nySe08/radar-chip-24ghz/divider/div_sensitivity.png

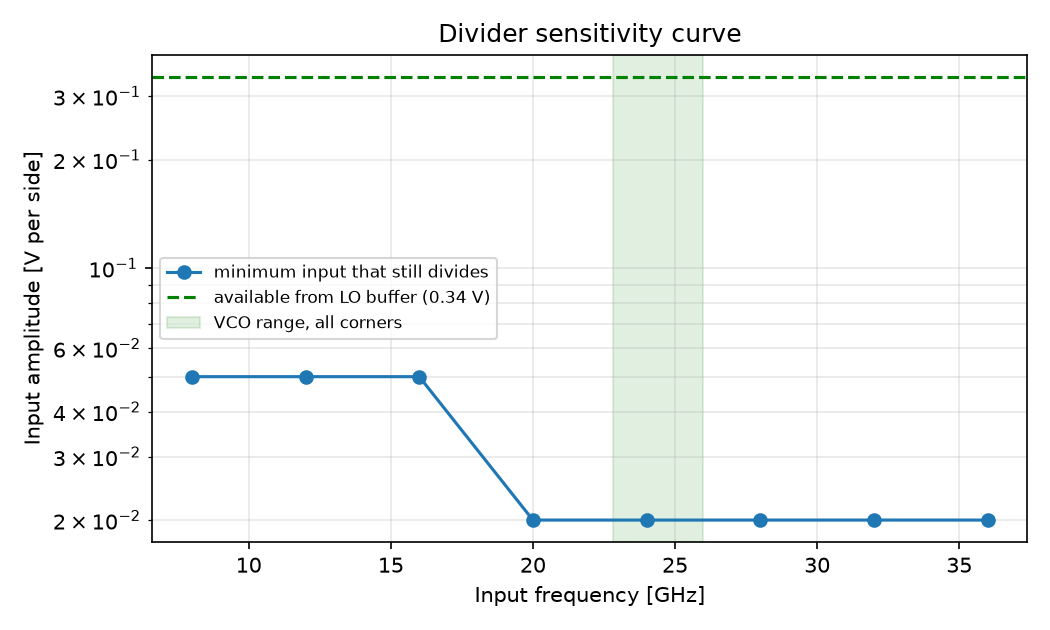
divider/div_sensitivity.png
