nySe08/radar-chip-24ghz/docs/chip_floorplan.png

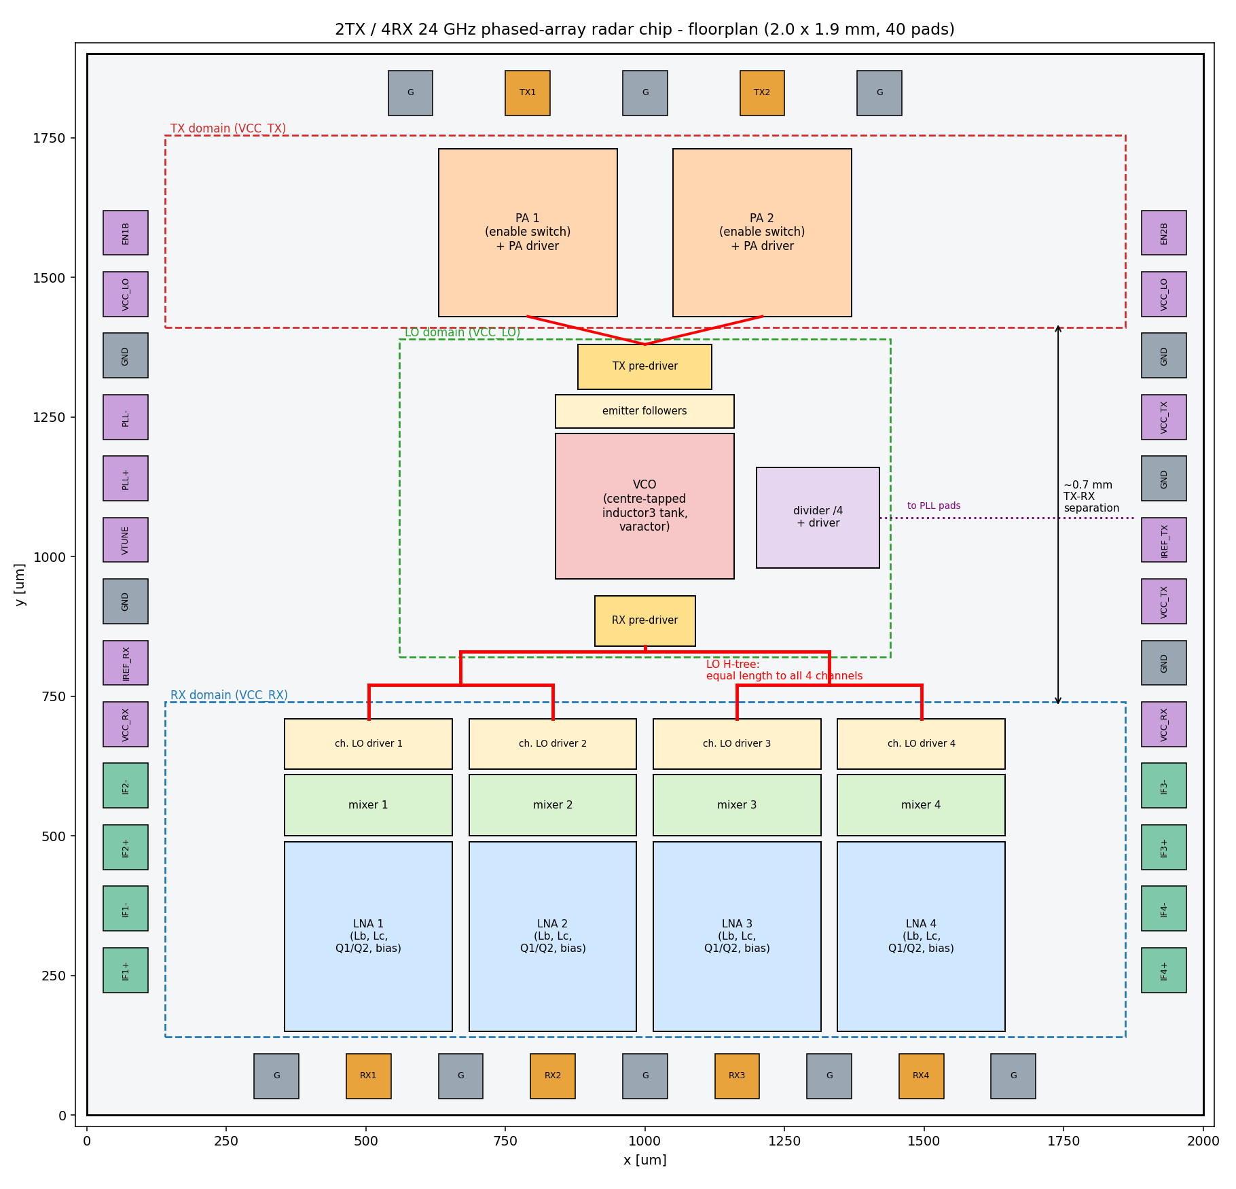
docs/chip_floorplan.png
