nySe08/radar-chip-24ghz/docs/cml_latch.png

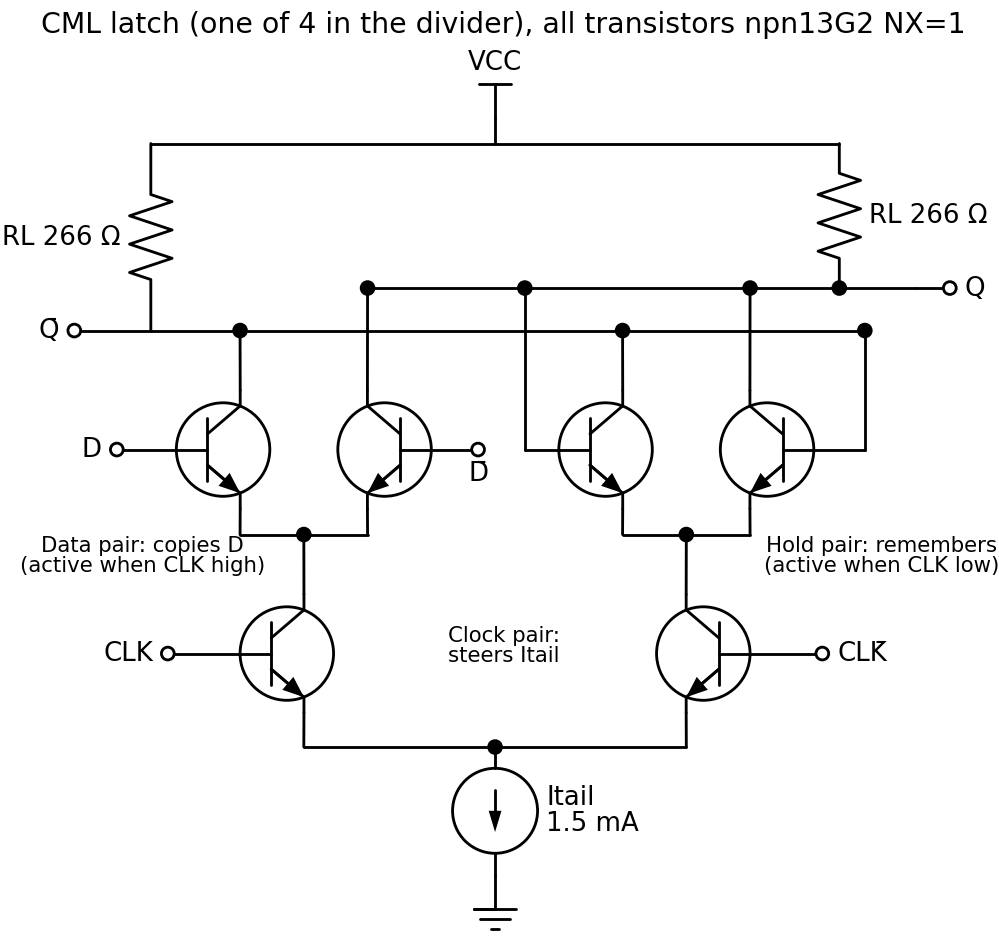
docs/cml_latch.png
