nySe08/radar-chip-24ghz/docs/div4_block.png

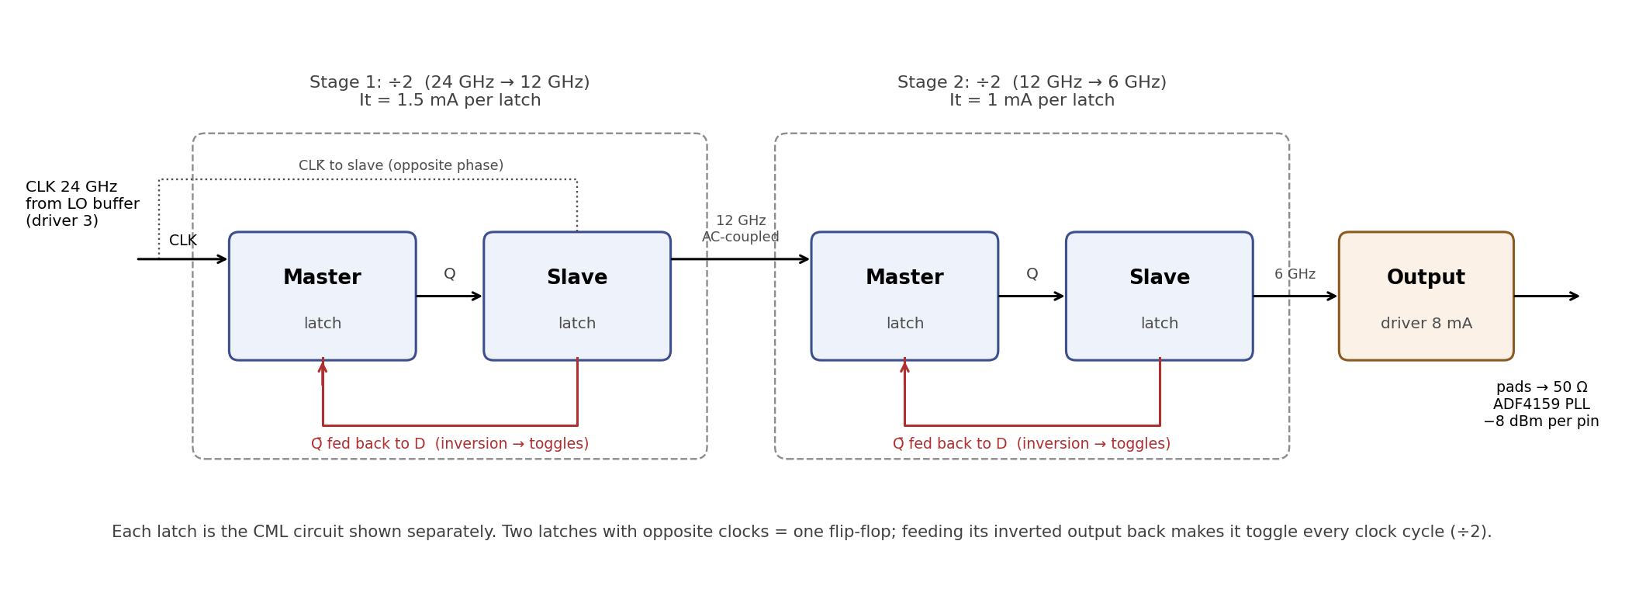
docs/div4_block.png
