nySe08/radar-chip-24ghz/docs/lna_schematic.png

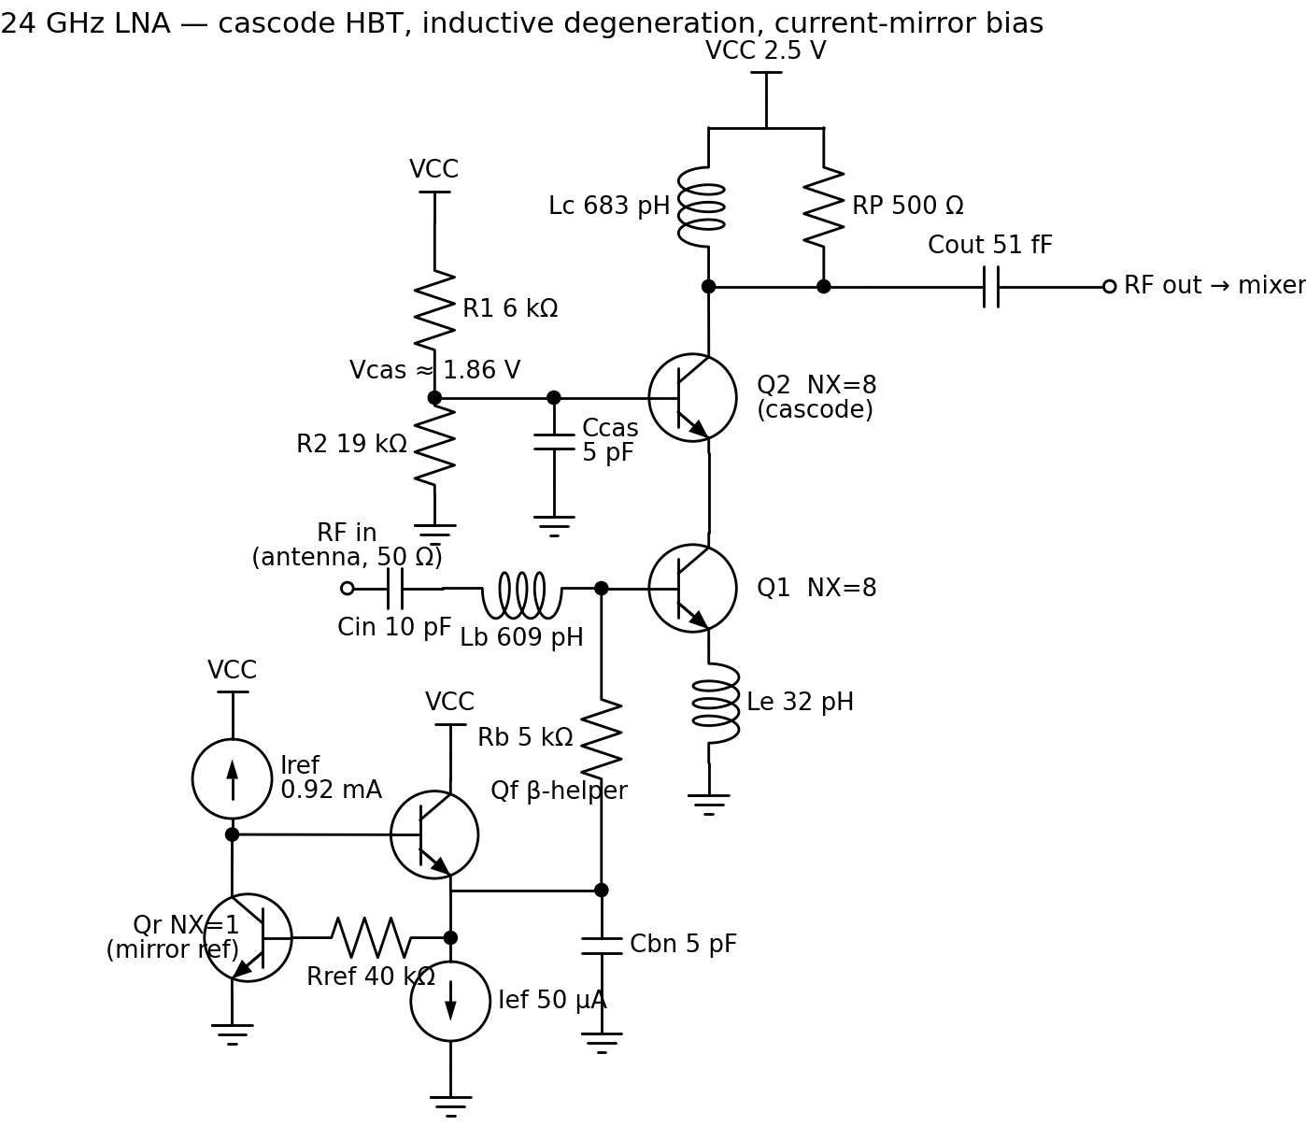
docs/lna_schematic.png
