nySe08/radar-chip-24ghz/docs/mixer_schematic.png

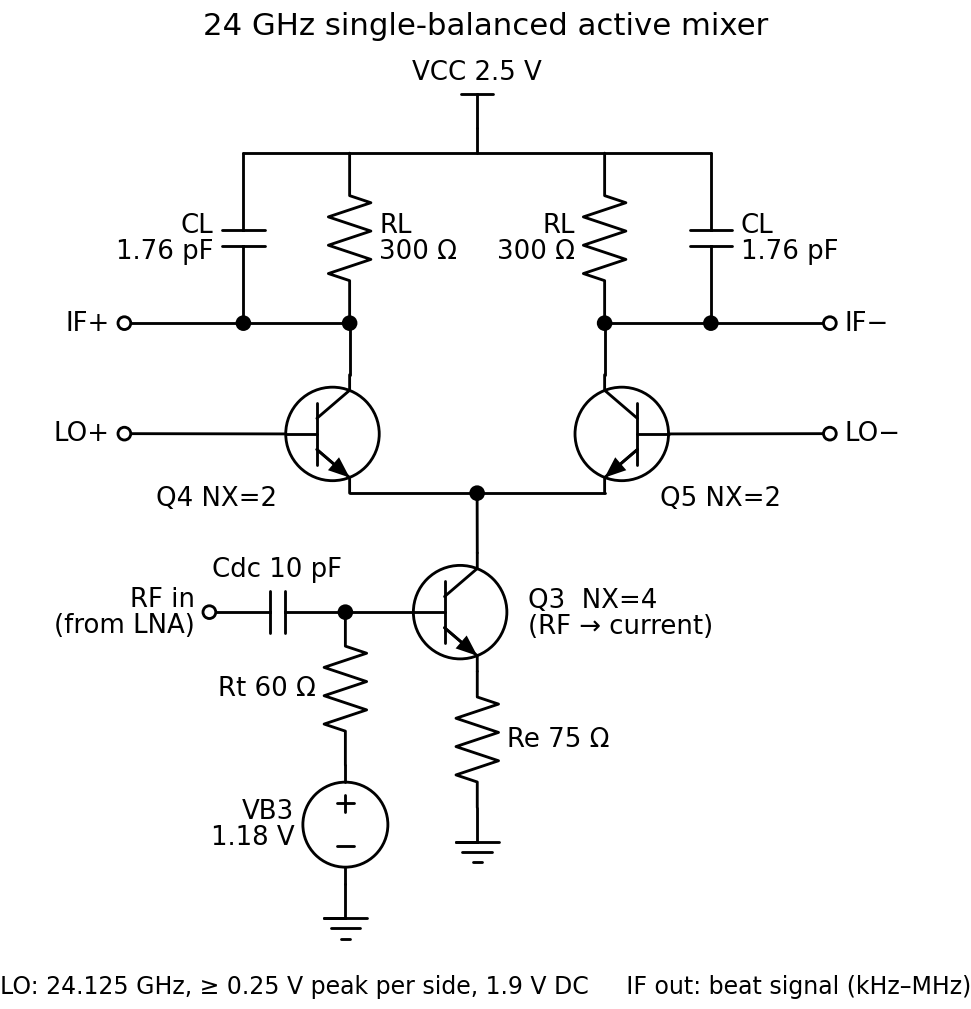
docs/mixer_schematic.png
