nySe08/radar-chip-24ghz/docs/pa_schematic.png

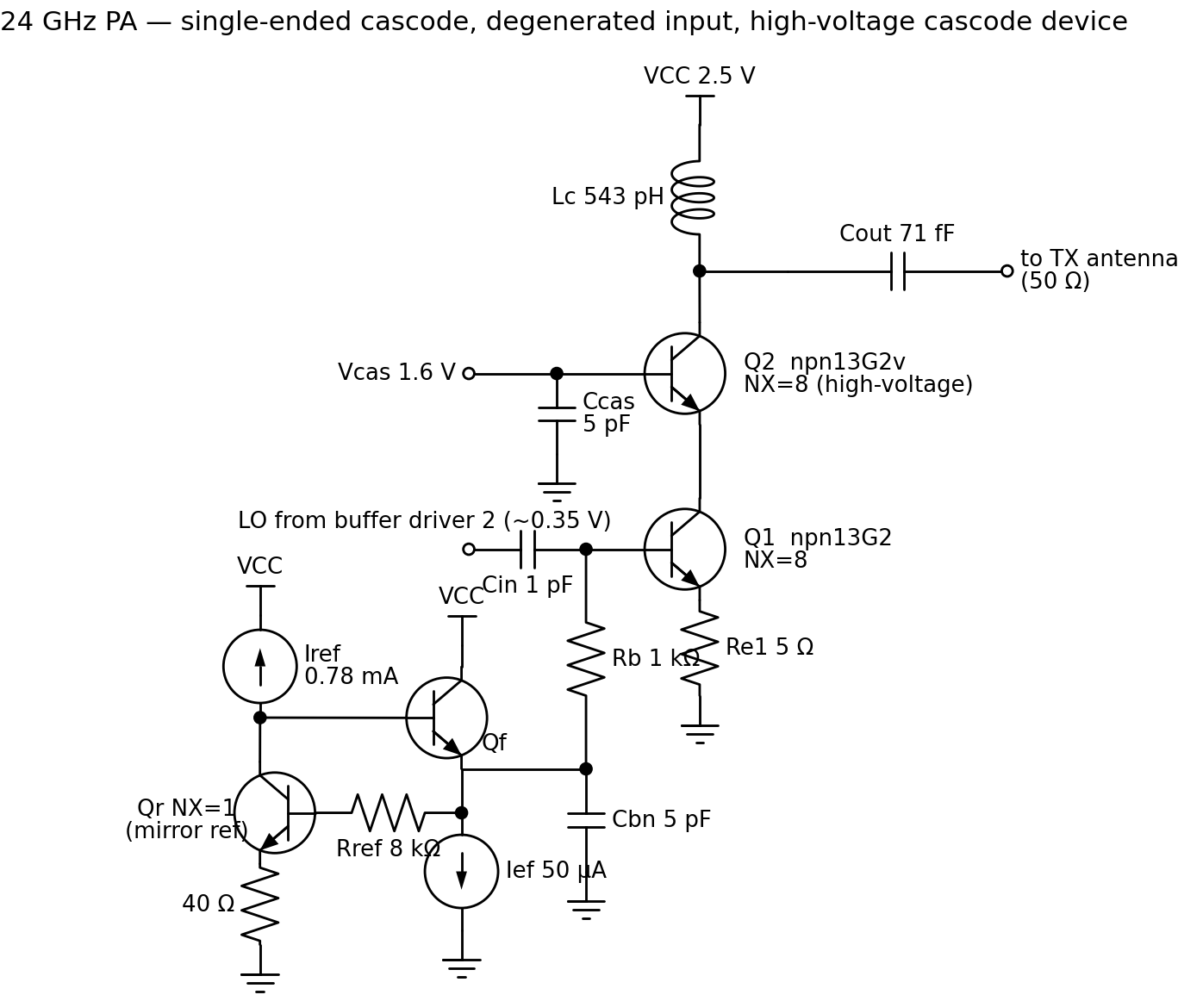
docs/pa_schematic.png
