nySe08/radar-chip-24ghz/floorplan/floorplan_full_chip.png

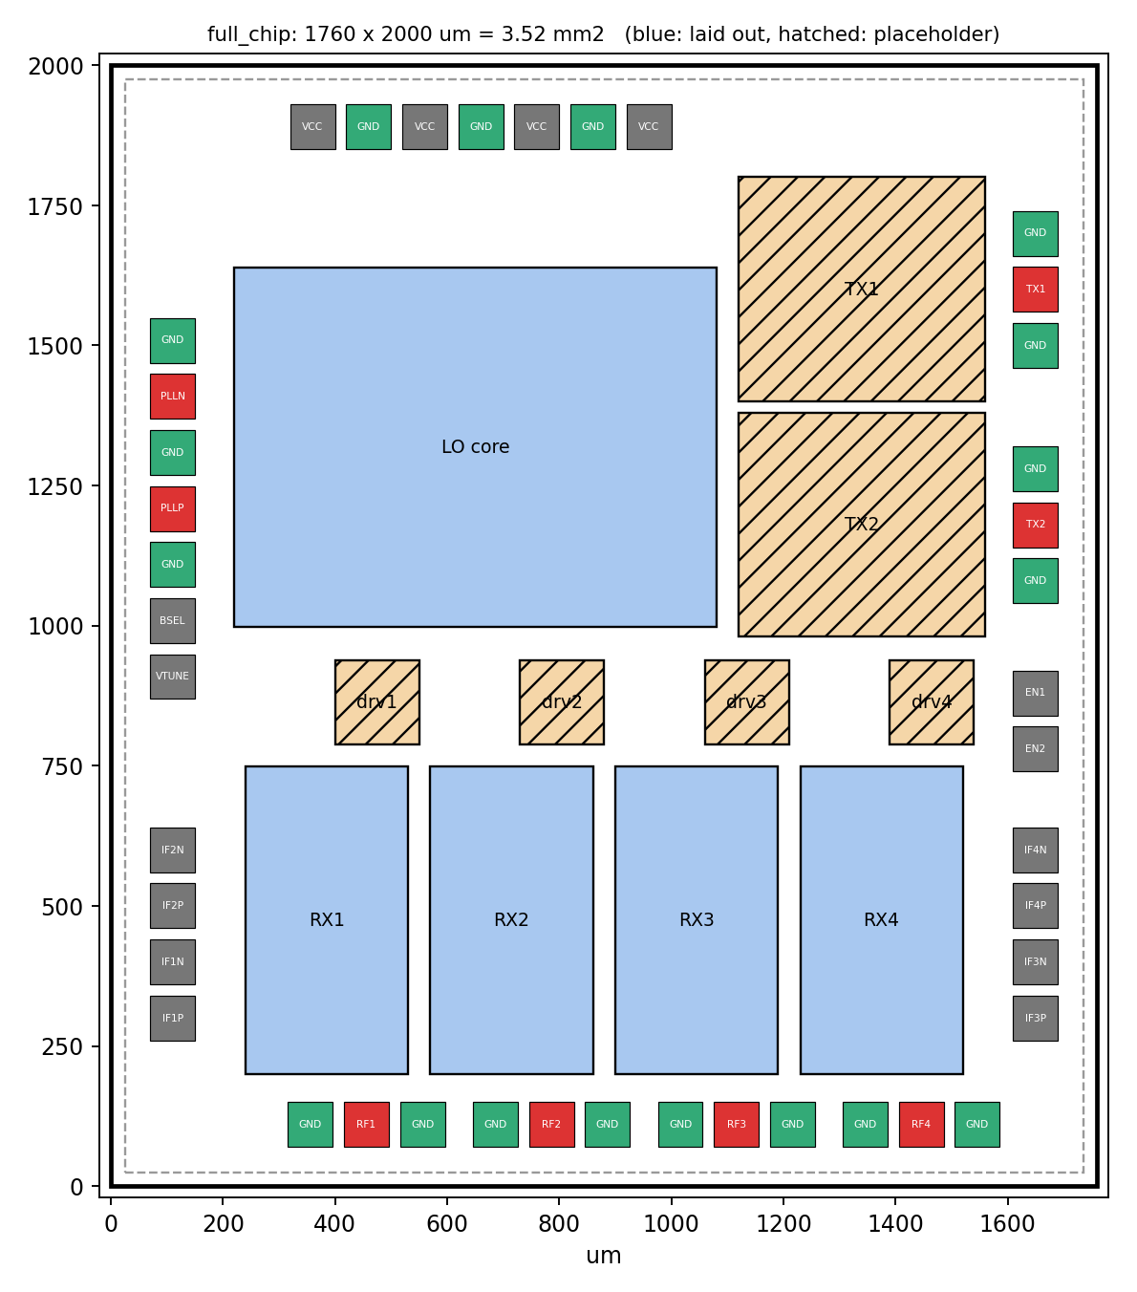
floorplan/floorplan_full_chip.png
