nySe08/radar-chip-24ghz/lna/char/hbt_char.png

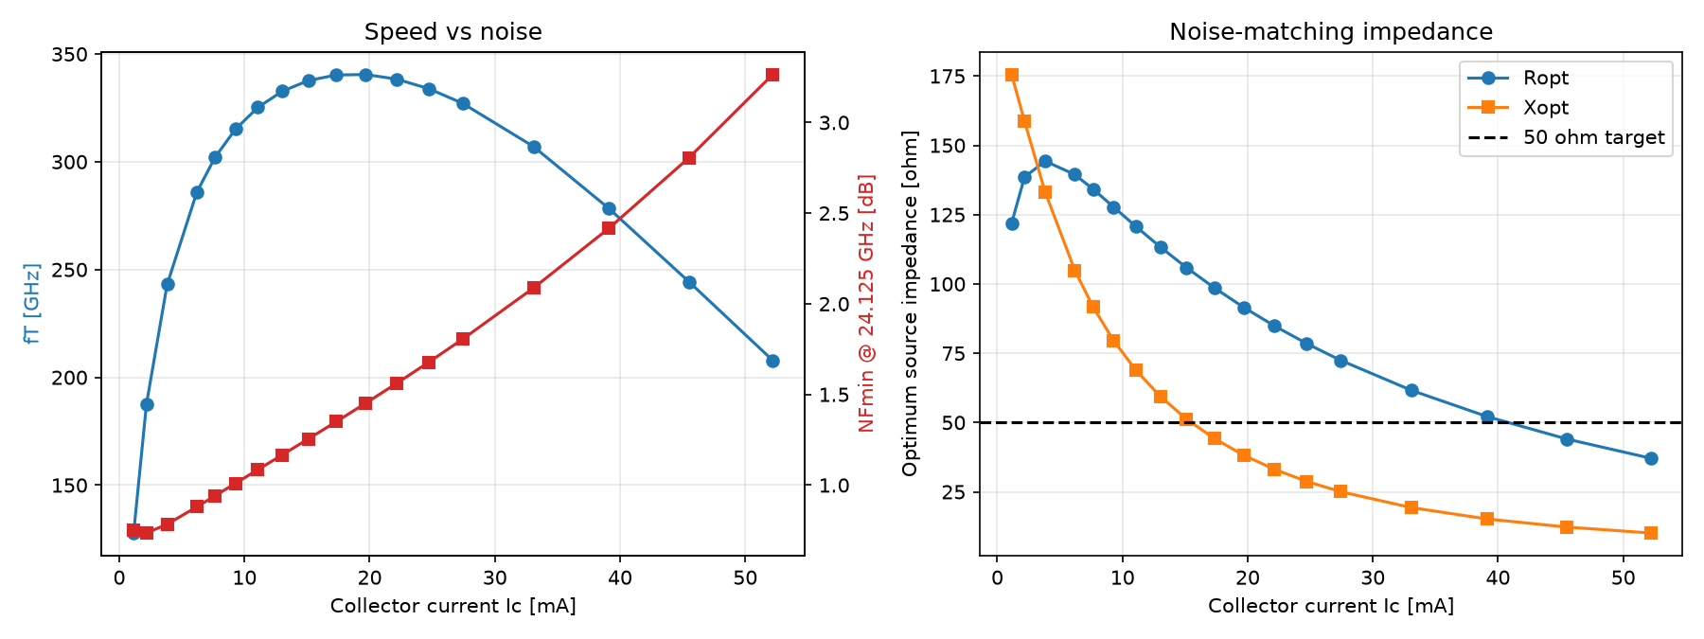
lna/char/hbt_char.png
