nySe08/radar-chip-24ghz/lna/em/lna_ind.png

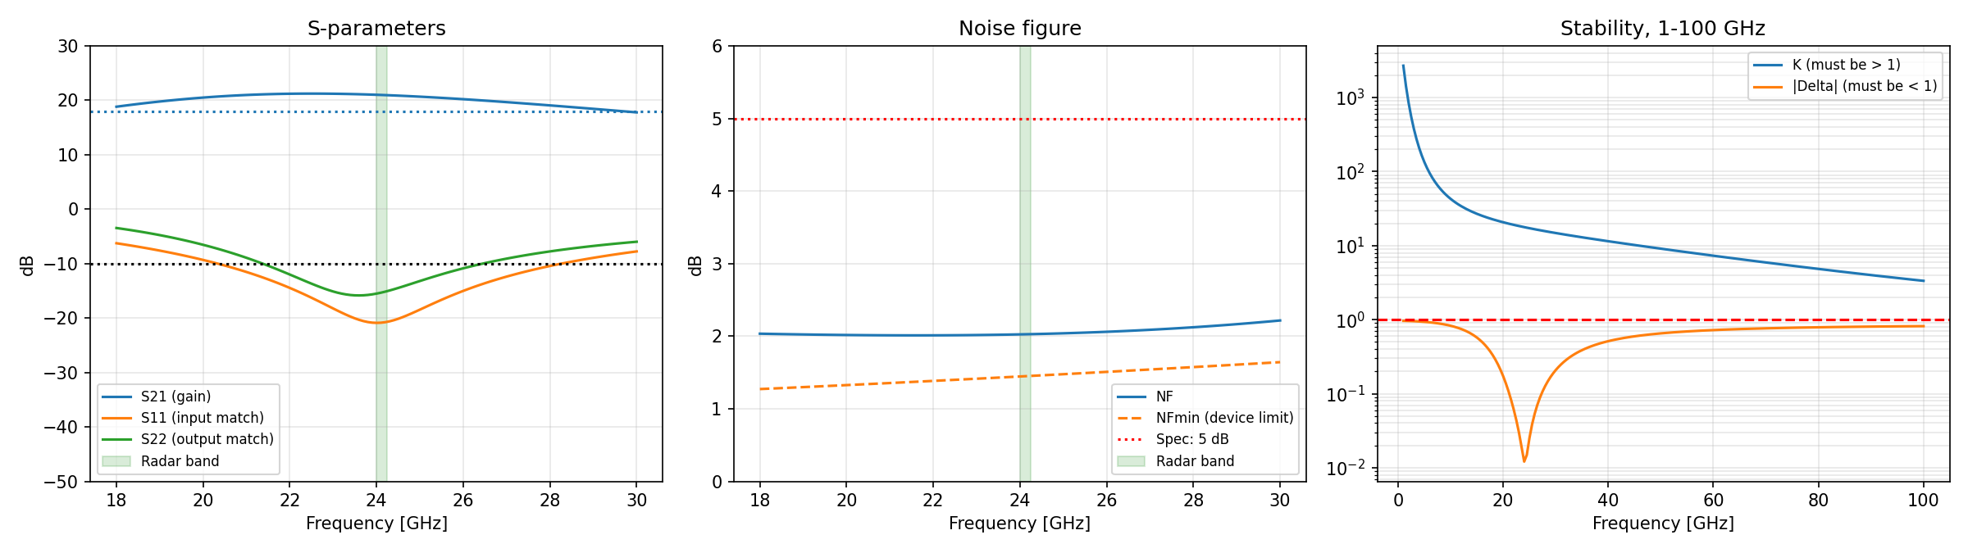
lna/em/lna_ind.png
