nySe08/radar-chip-24ghz/lna/em/output/ind_esd_rx_w5_n3_d86_p_data/sub-1/ind_esd_rx_w5_n3_d86_p_em.png

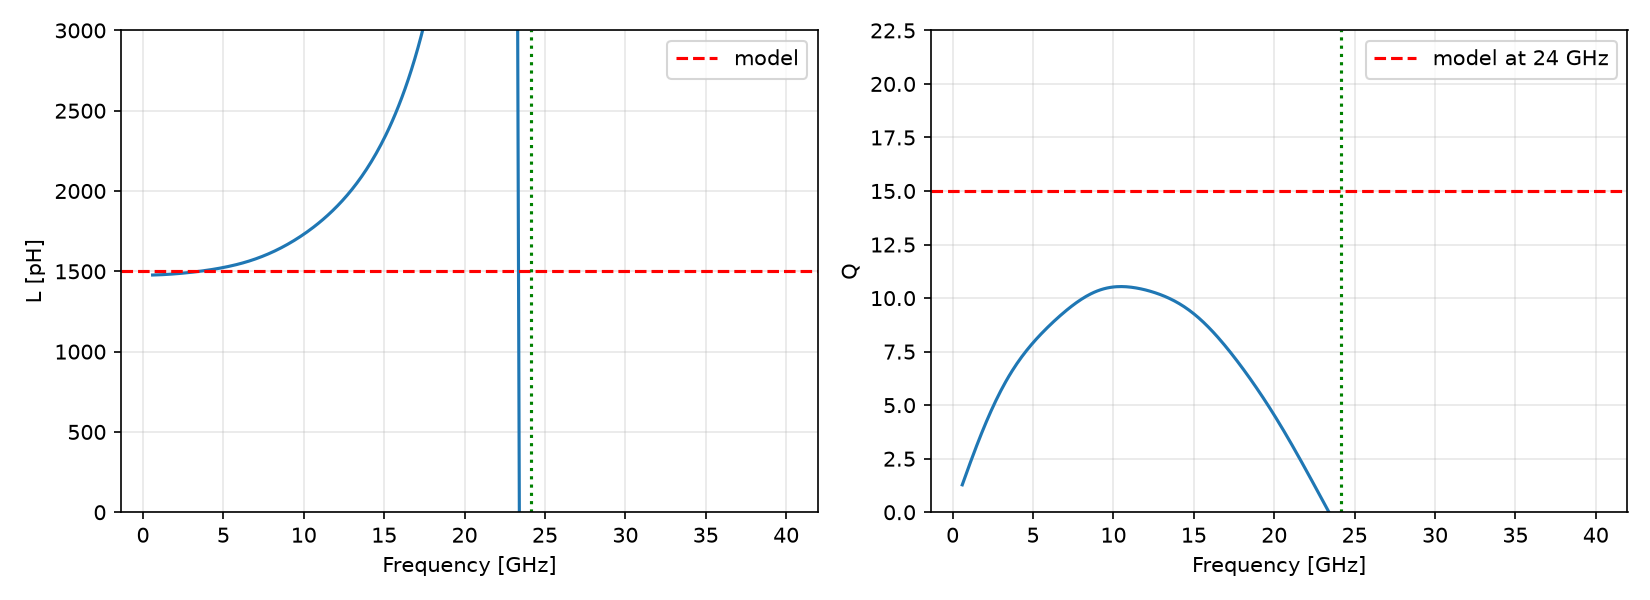
lna/em/output/ind_esd_rx_w5_n3_d86_p_data/sub-1/ind_esd_rx_w5_n3_d86_p_em.png
