nySe08/radar-chip-24ghz/lna/em/output/ind_esd_tx_w7_n2_d77_p_data/sub-1/ind_esd_tx_w7_n2_d77_p_em.png

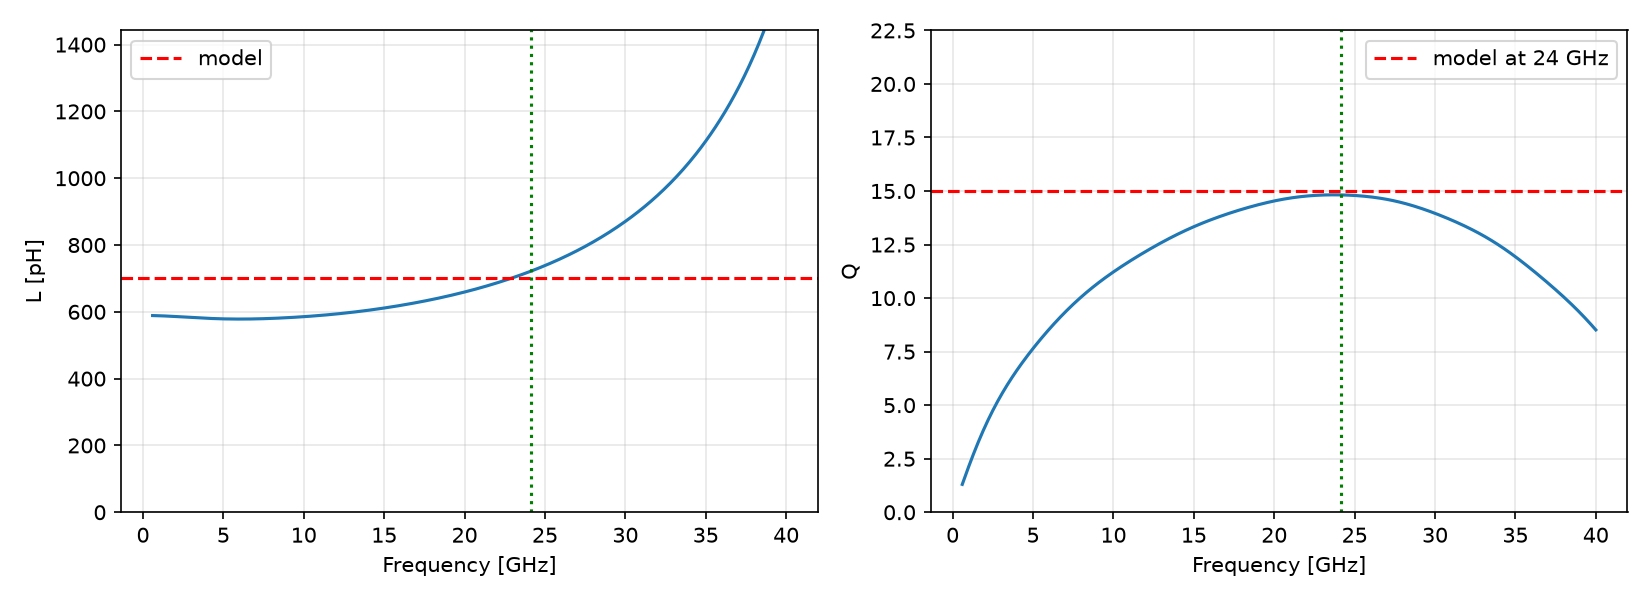
lna/em/output/ind_esd_tx_w7_n2_d77_p_data/sub-1/ind_esd_tx_w7_n2_d77_p_em.png
