nySe08/radar-chip-24ghz/lna/em/output/ind_lb2_data/sub-1/ind_lb2_em.png

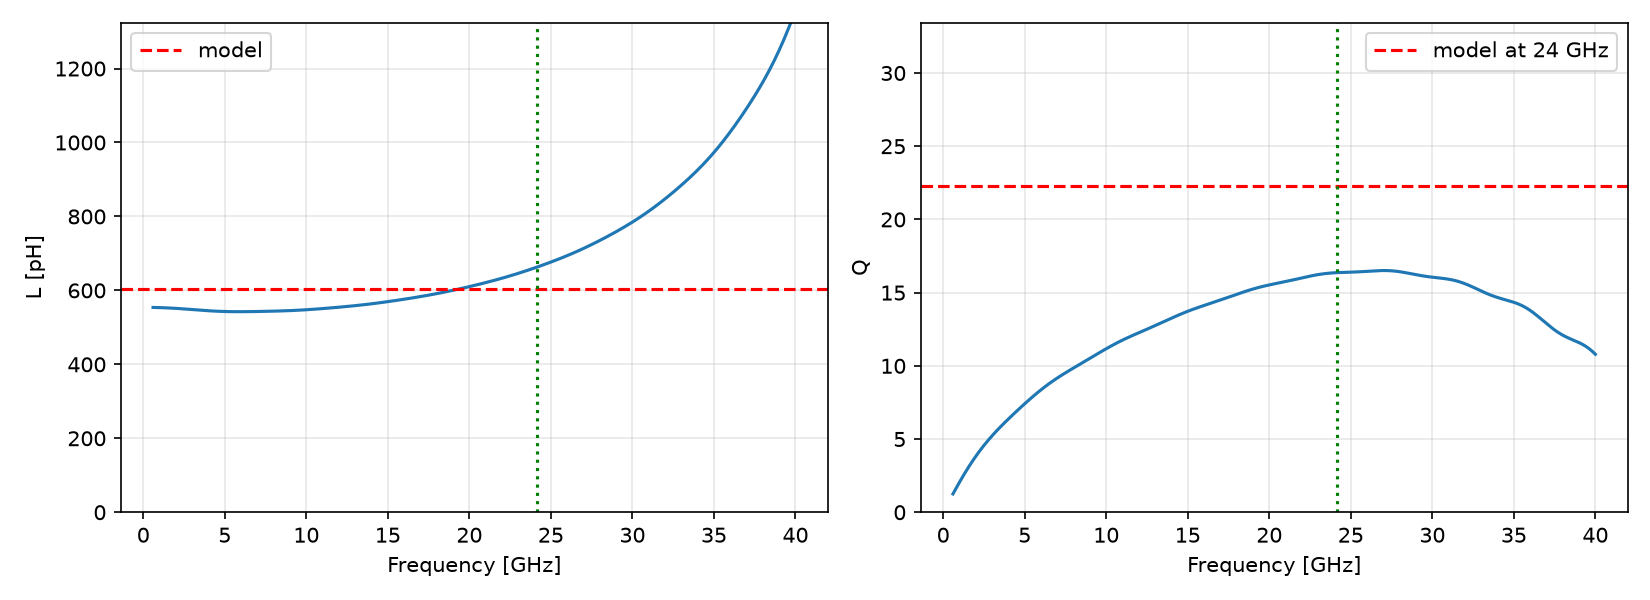
lna/em/output/ind_lb2_data/sub-1/ind_lb2_em.png
