nySe08/radar-chip-24ghz/lna/em/output/ind_lb3_p_data/sub-1/ind_lb3_p_em.png

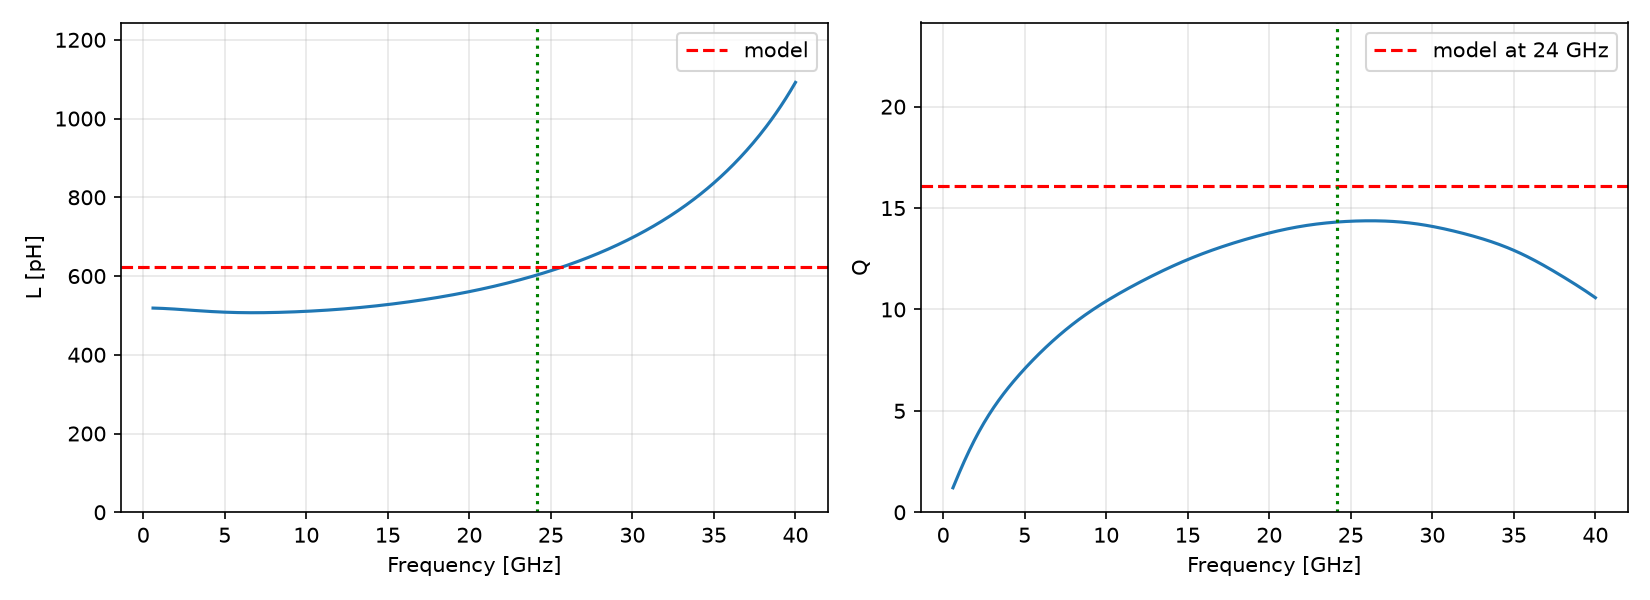
lna/em/output/ind_lb3_p_data/sub-1/ind_lb3_p_em.png
