nySe08/radar-chip-24ghz/lna/em/output/ind_lb_tile_w5_d54p5_p_data/sub-1/ind_lb_tile_w5_d54p5_p_em.png

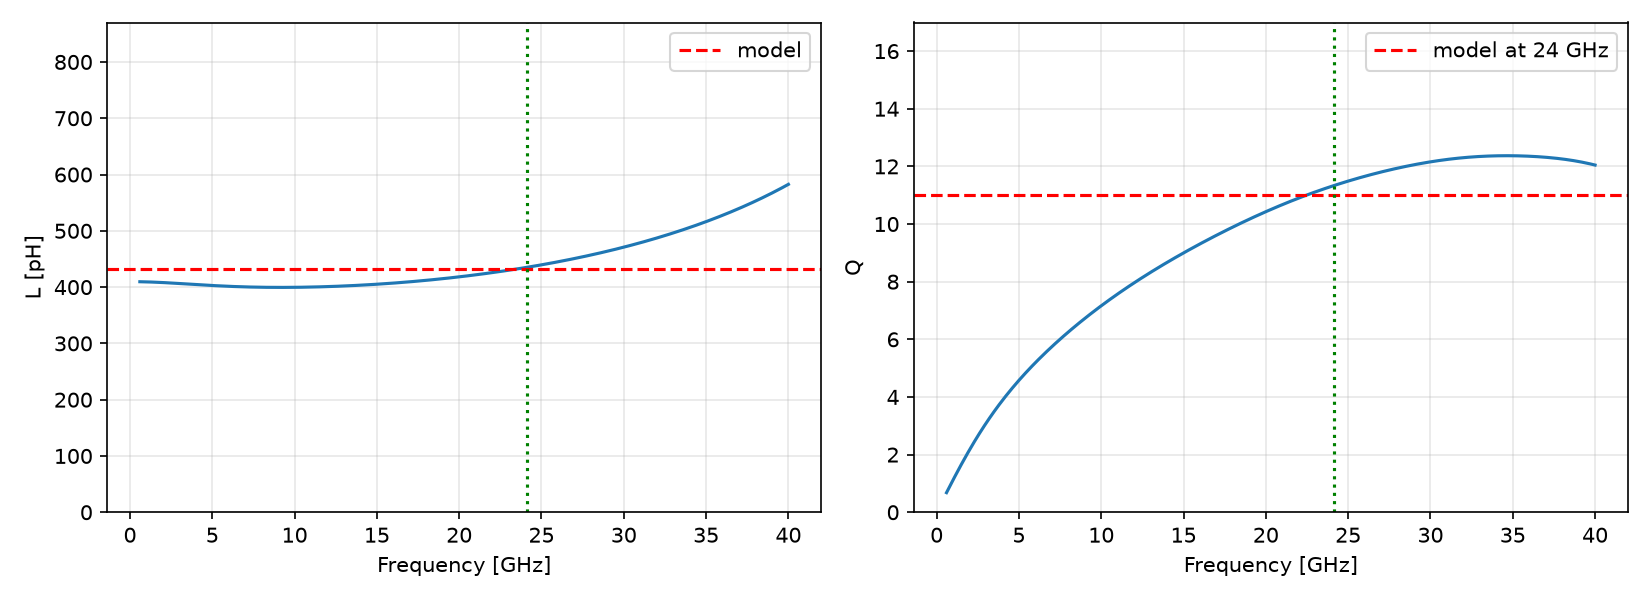
lna/em/output/ind_lb_tile_w5_d54p5_p_data/sub-1/ind_lb_tile_w5_d54p5_p_em.png
