nySe08/radar-chip-24ghz/lna/em/output/ind_lc7_w4_d44_p_data/sub-1/ind_lc7_w4_d44_p_em.png

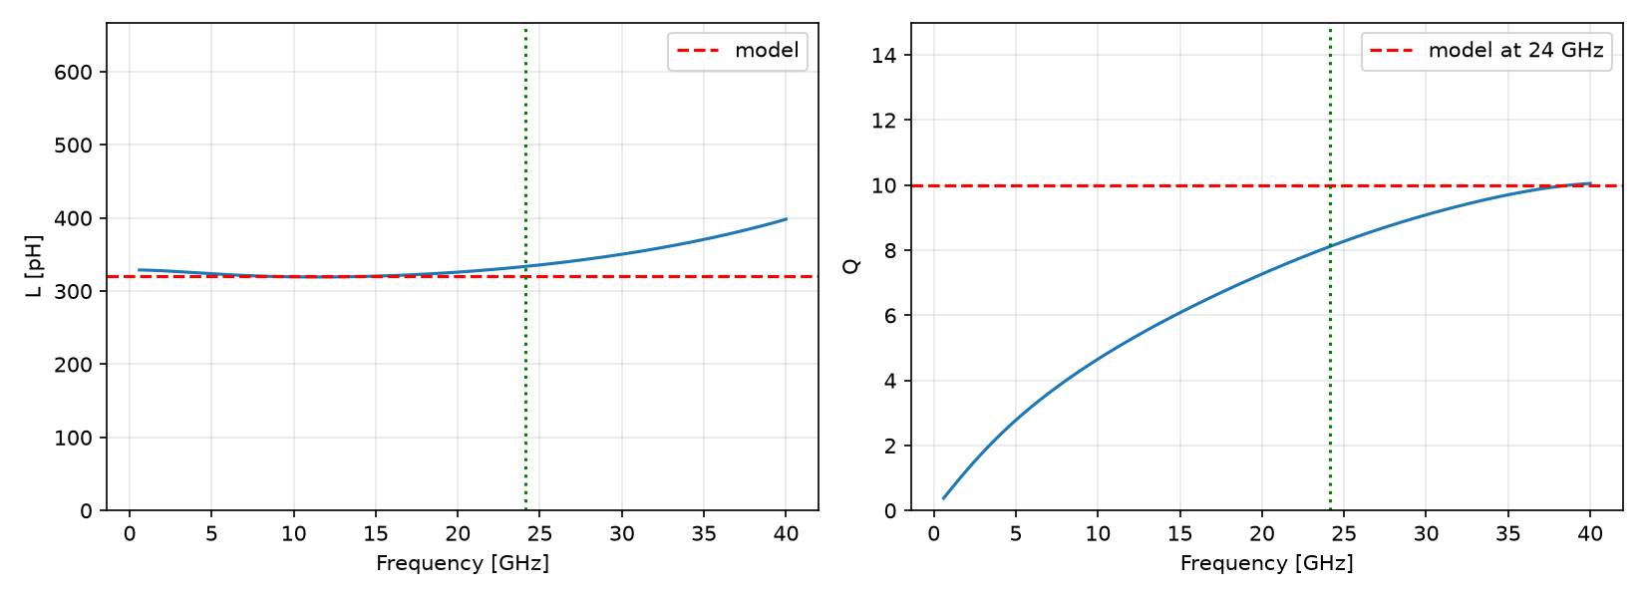
lna/em/output/ind_lc7_w4_d44_p_data/sub-1/ind_lc7_w4_d44_p_em.png
