nySe08/radar-chip-24ghz/lna/em/output/ind_lo4_data/sub-1/ind_lo4_em.png

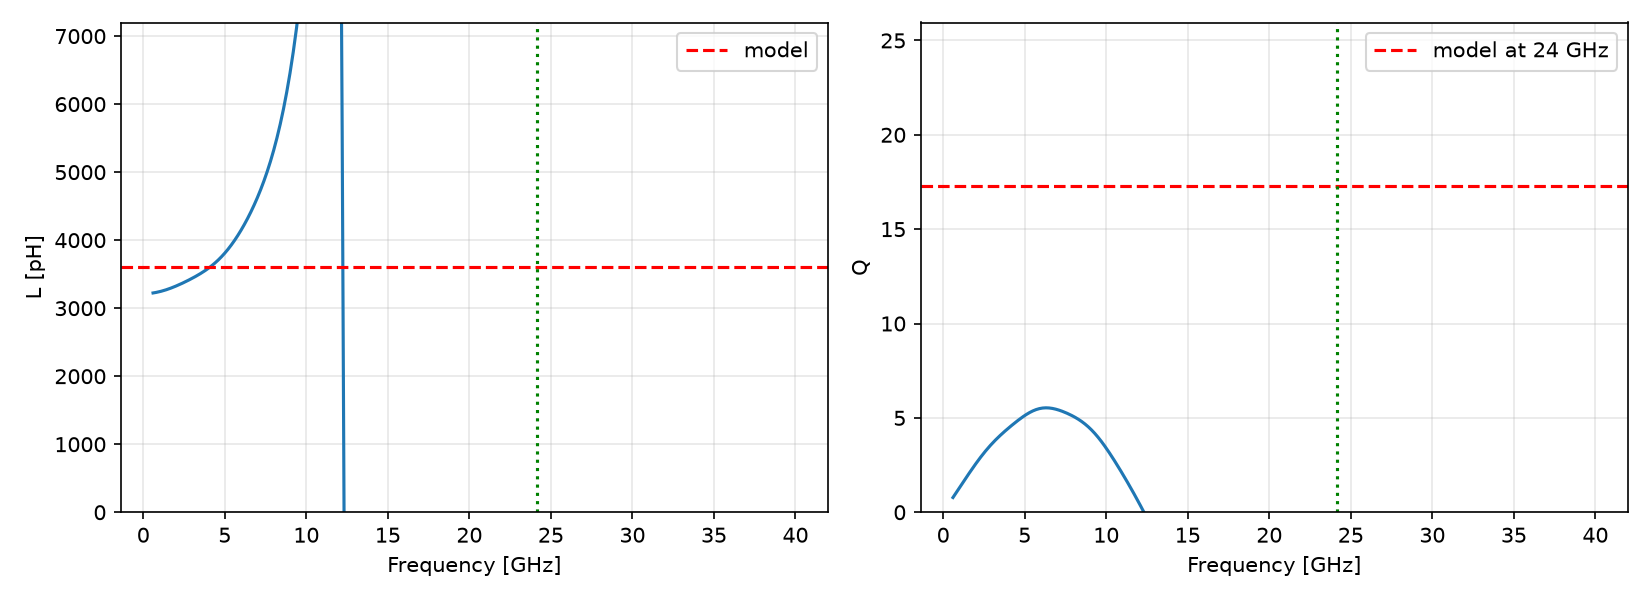
lna/em/output/ind_lo4_data/sub-1/ind_lo4_em.png
