nySe08/radar-chip-24ghz/lna/em/output/ind_pa2_data/sub-1/ind_pa2_em.png

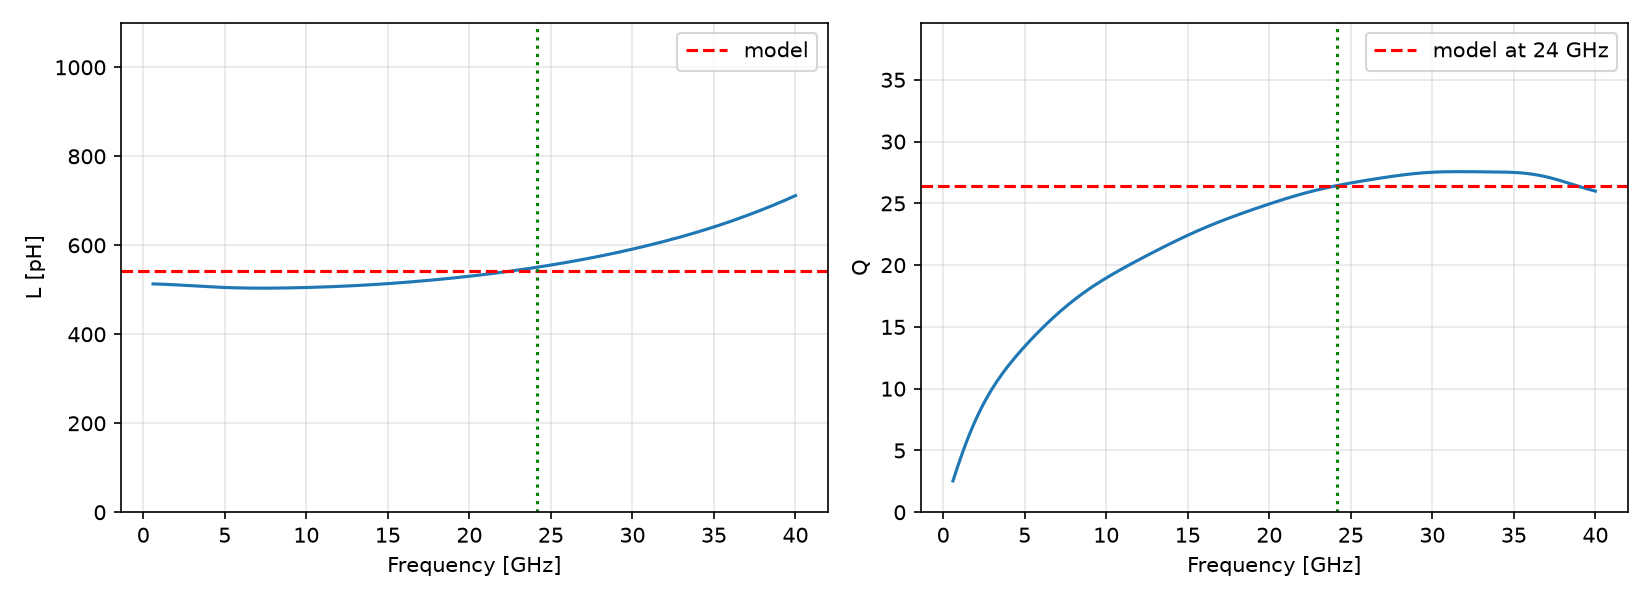
lna/em/output/ind_pa2_data/sub-1/ind_pa2_em.png
