nySe08/radar-chip-24ghz/lna/em/output/ind_rxpre_data/sub-1/ind_rxpre_em.png

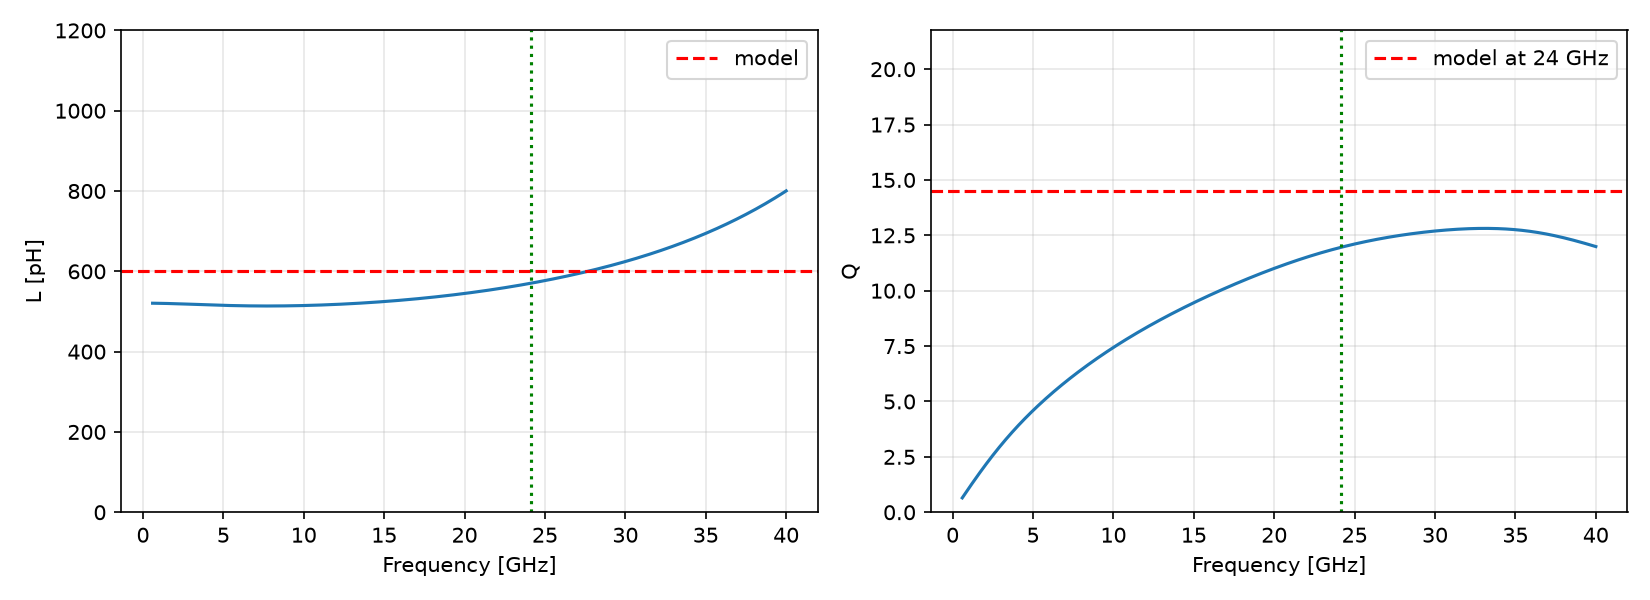
lna/em/output/ind_rxpre_data/sub-1/ind_rxpre_em.png
