nySe08/radar-chip-24ghz/lna/em/output/ind_txpre_data/sub-1/ind_txpre_em.png

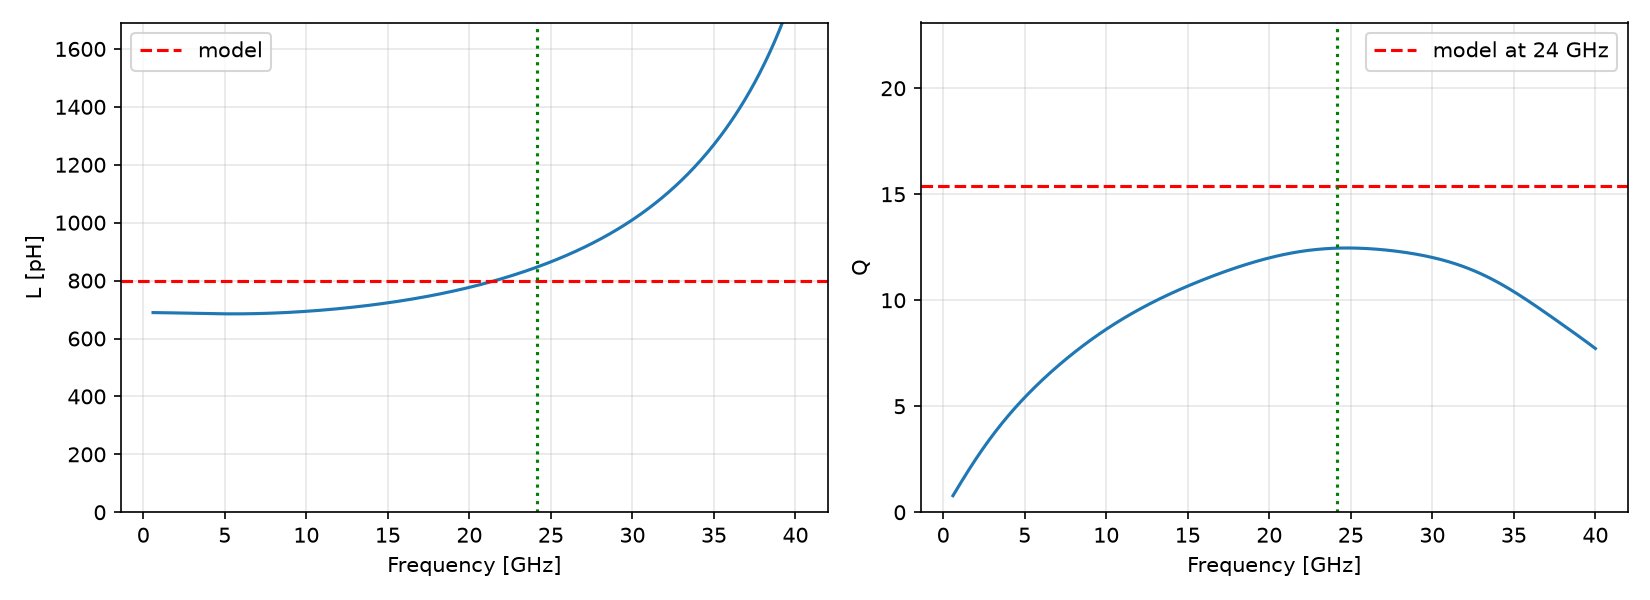
lna/em/output/ind_txpre_data/sub-1/ind_txpre_em.png
