nySe08/radar-chip-24ghz/lna/em/output/ind_vco2_data/sub-1/ind_vco2_em.png

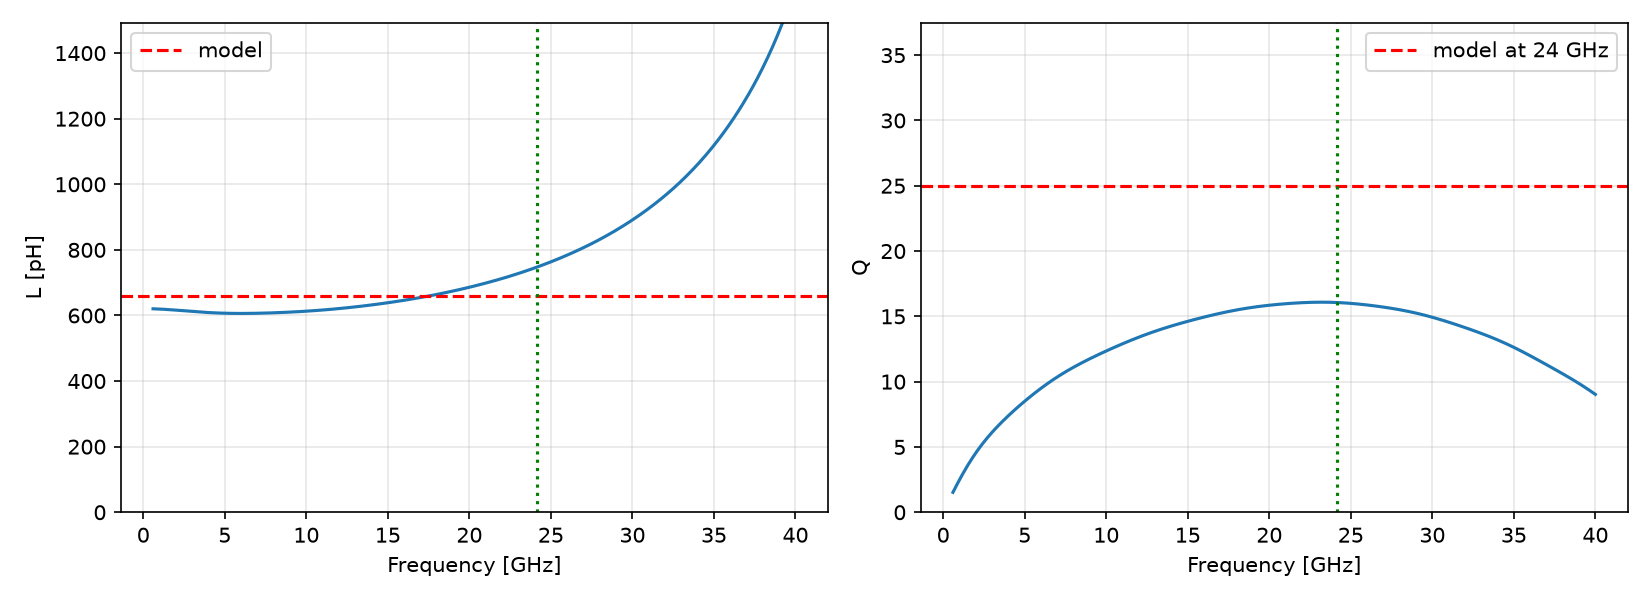
lna/em/output/ind_vco2_data/sub-1/ind_vco2_em.png
