nySe08/radar-chip-24ghz/lna/em/output/ind_vco3_data/sub-1/ind_vco3_em.png

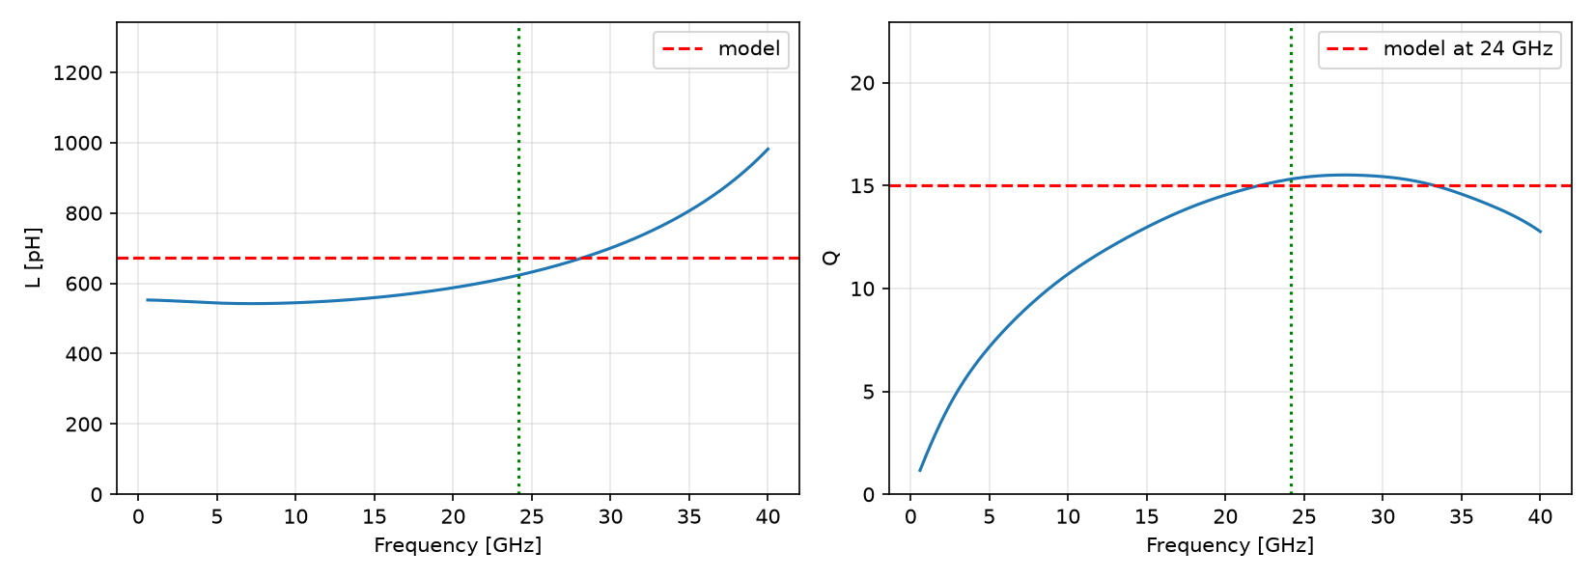
lna/em/output/ind_vco3_data/sub-1/ind_vco3_em.png
