nySe08/radar-chip-24ghz/lna/em/output/ind_vco_data/sub-1/ind_vco_em.png

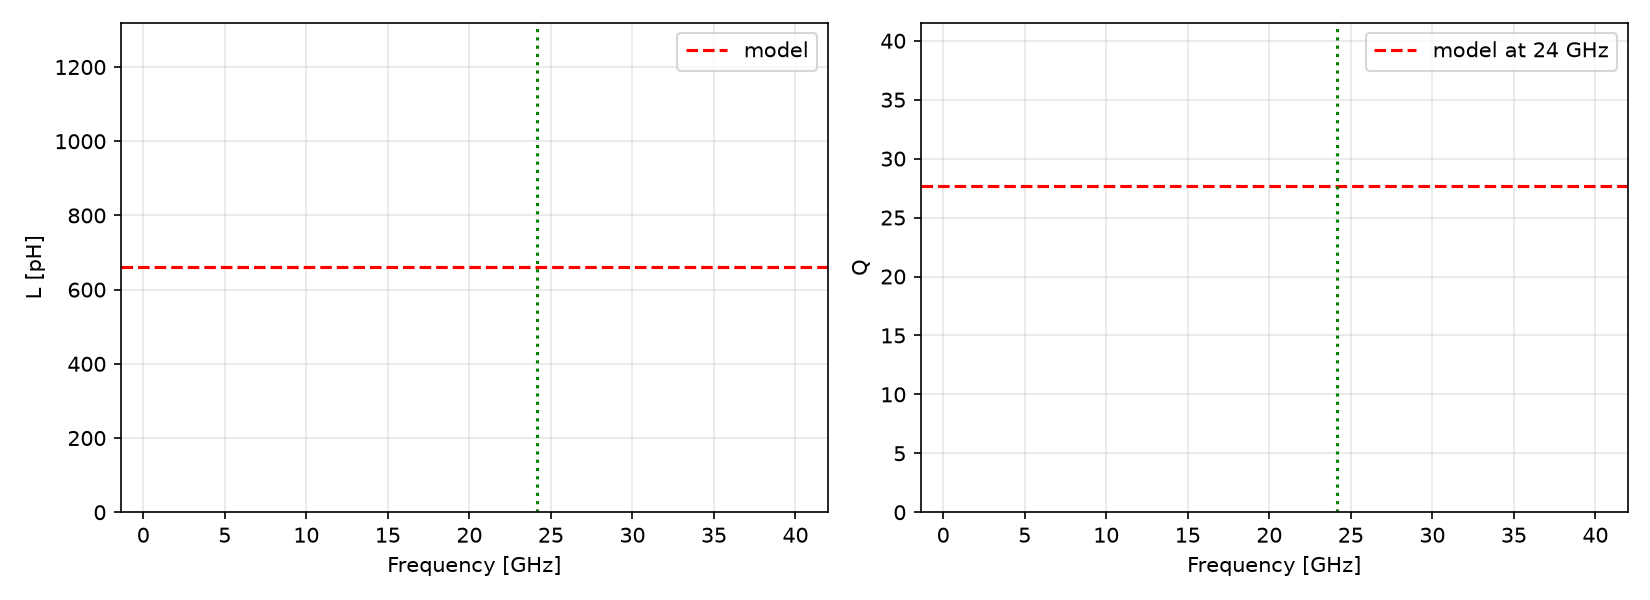
lna/em/output/ind_vco_data/sub-1/ind_vco_em.png
