nySe08/radar-chip-24ghz/lna/em/output/run_ind_lb_data/sub-1/ind_lb_em.png

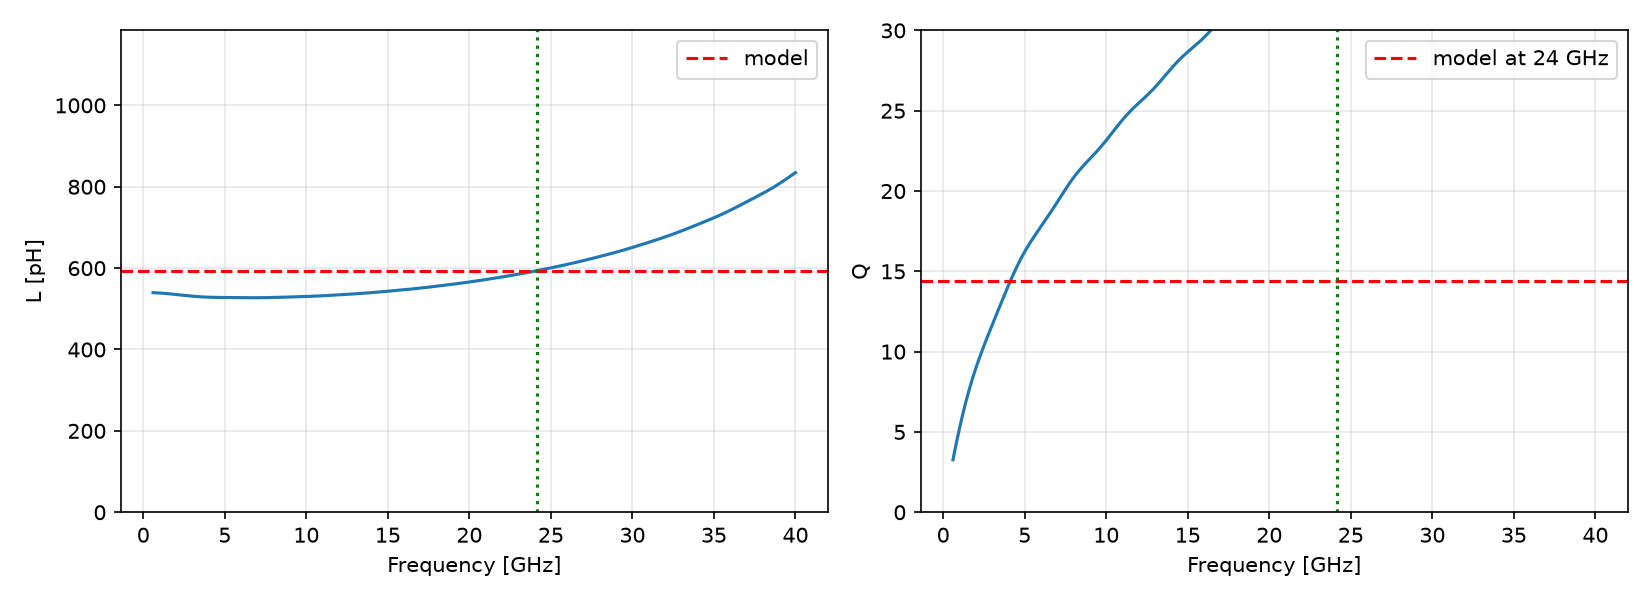
lna/em/output/run_ind_lb_data/sub-1/ind_lb_em.png
