nySe08/radar-chip-24ghz/lna/em/output/vco_coil_w10_n1_d150.0_p_data/sub-1/vco_coil_w10_n1_d150.0_p_em.png

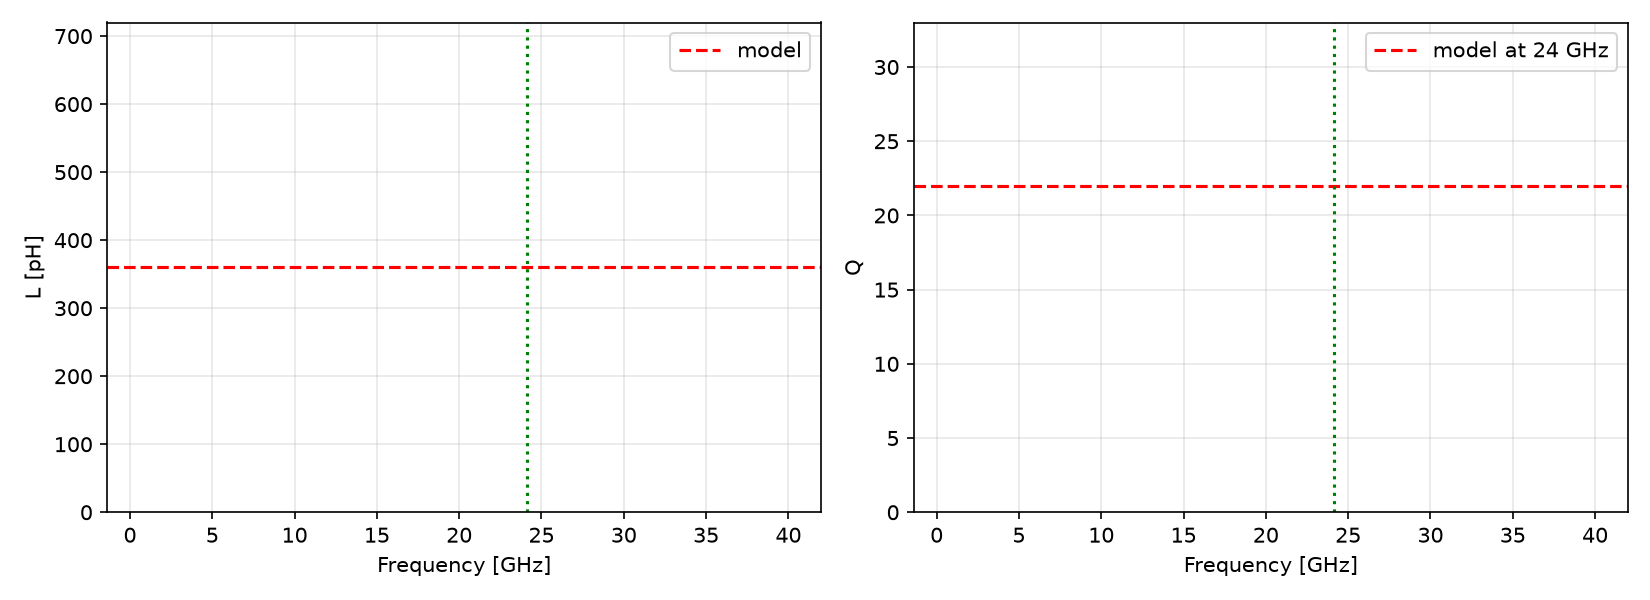
lna/em/output/vco_coil_w10_n1_d150.0_p_data/sub-1/vco_coil_w10_n1_d150.0_p_em.png
