nySe08/radar-chip-24ghz/lna/layout/lna_bias_v3b.png

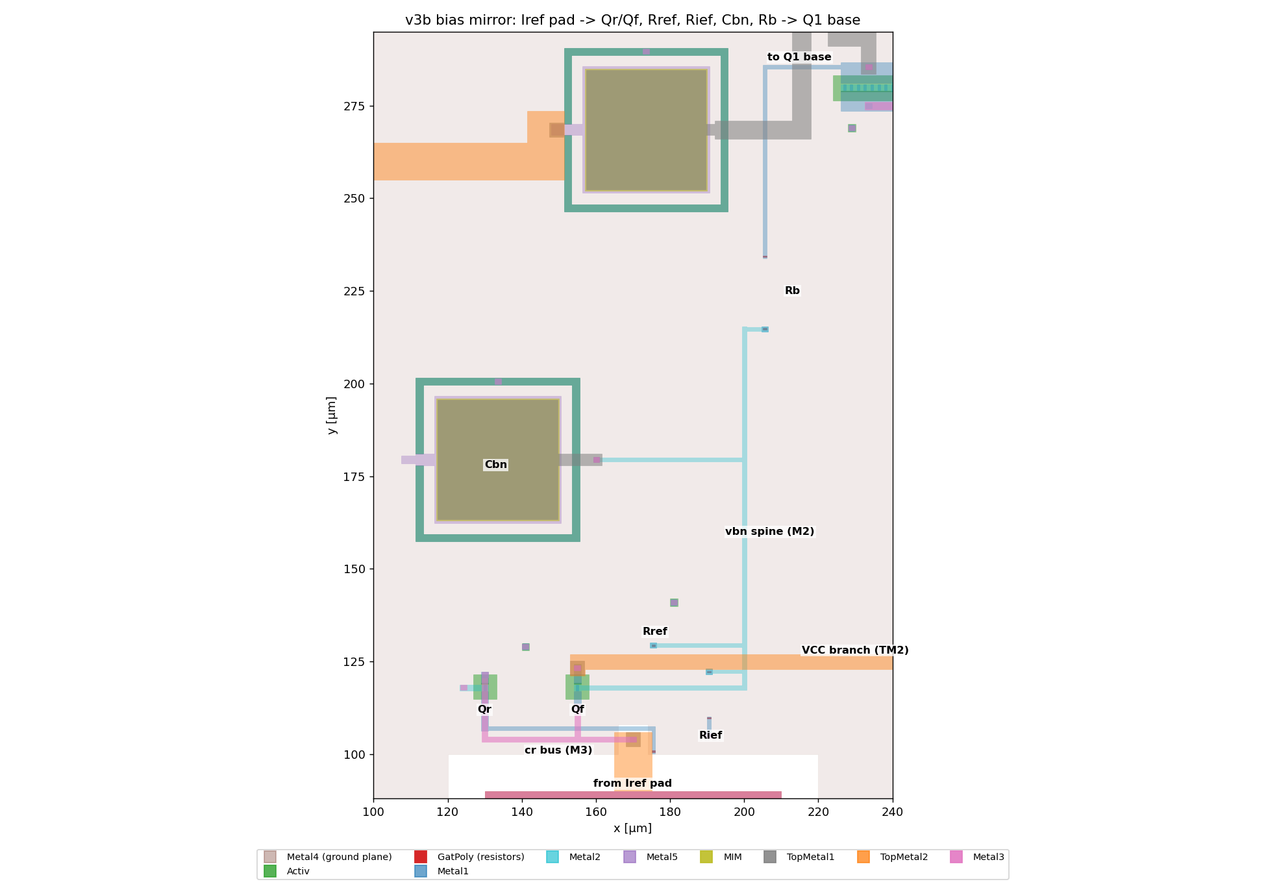
lna/layout/lna_bias_v3b.png
