nySe08/radar-chip-24ghz/lna/layout/lna_core_v2.png

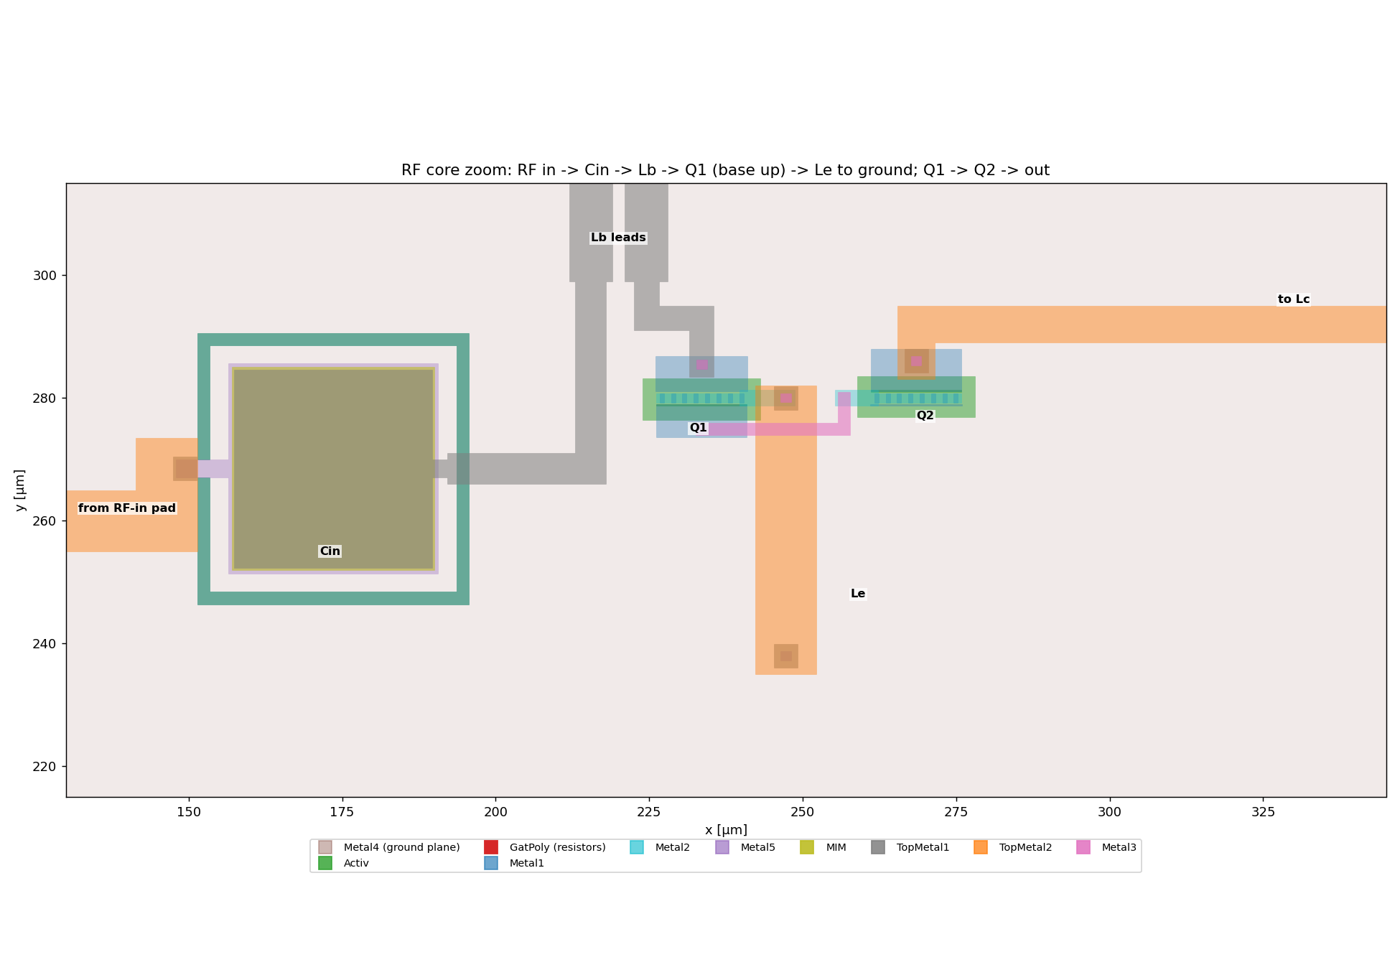
lna/layout/lna_core_v2.png
