nySe08/radar-chip-24ghz/lna/layout/lna_out_v3a.png

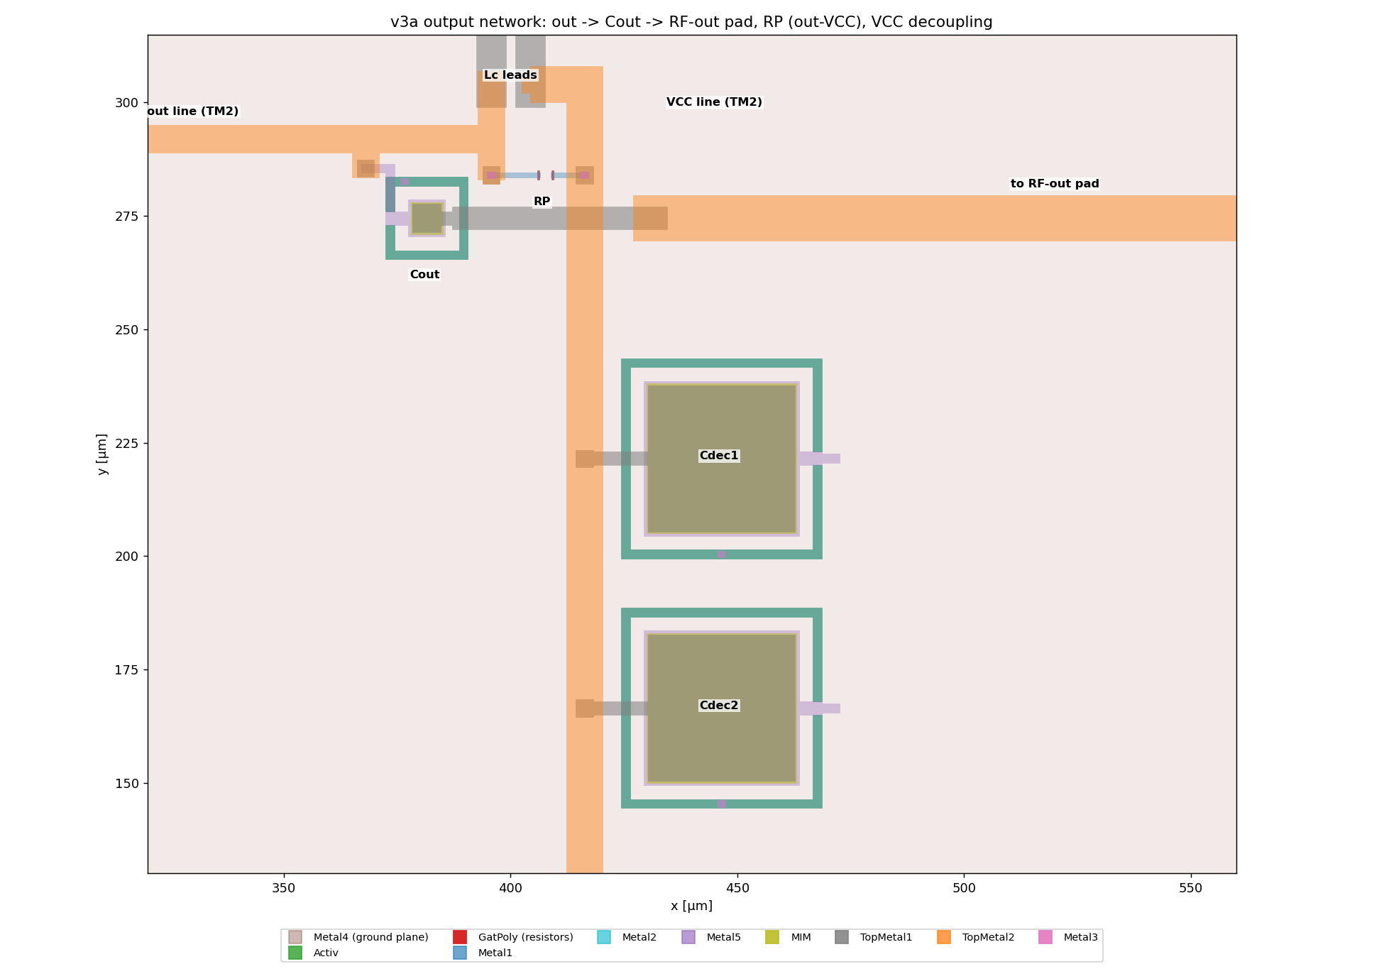
lna/layout/lna_out_v3a.png
