nySe08/radar-chip-24ghz/lna/stage1/lna_real.png

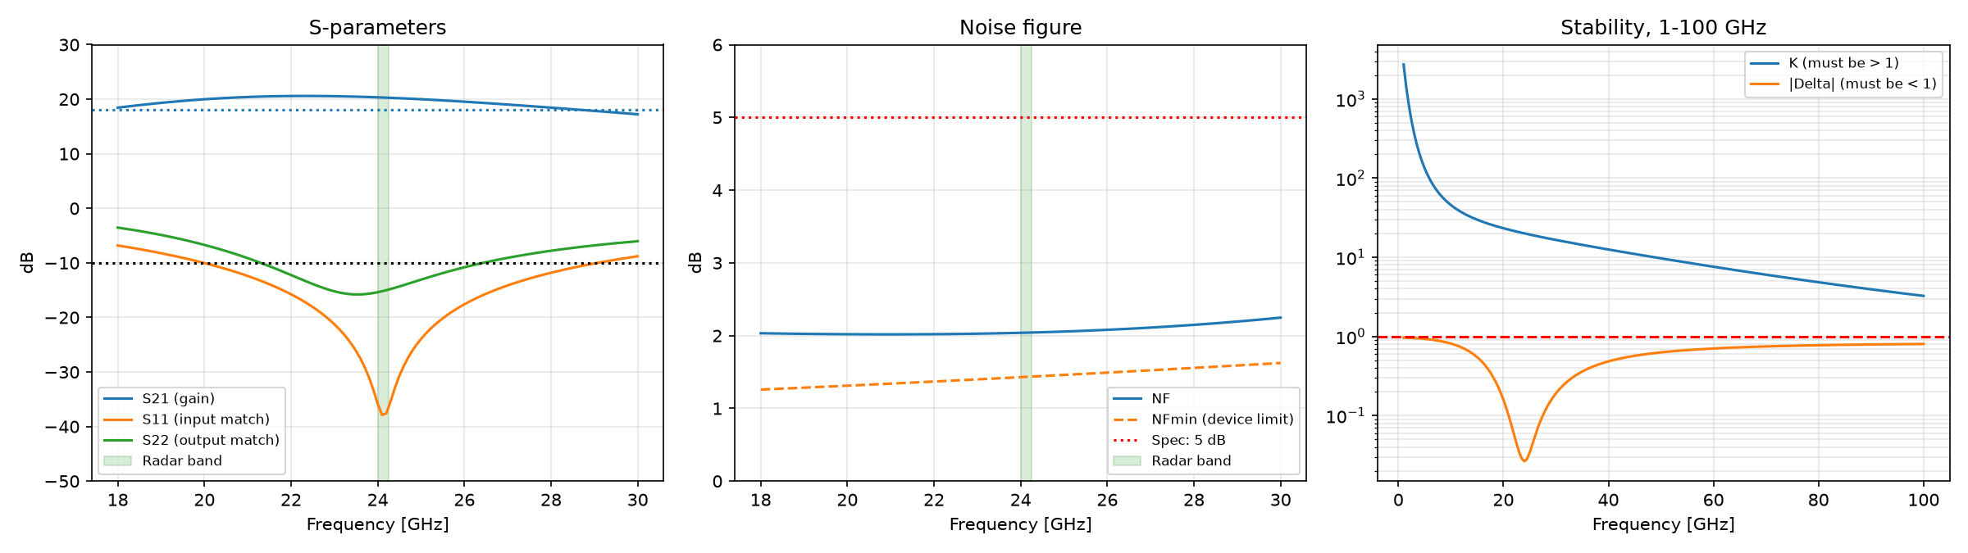
lna/stage1/lna_real.png
