nySe08/radar-chip-24ghz/lna/stage1/lna_stage1.png

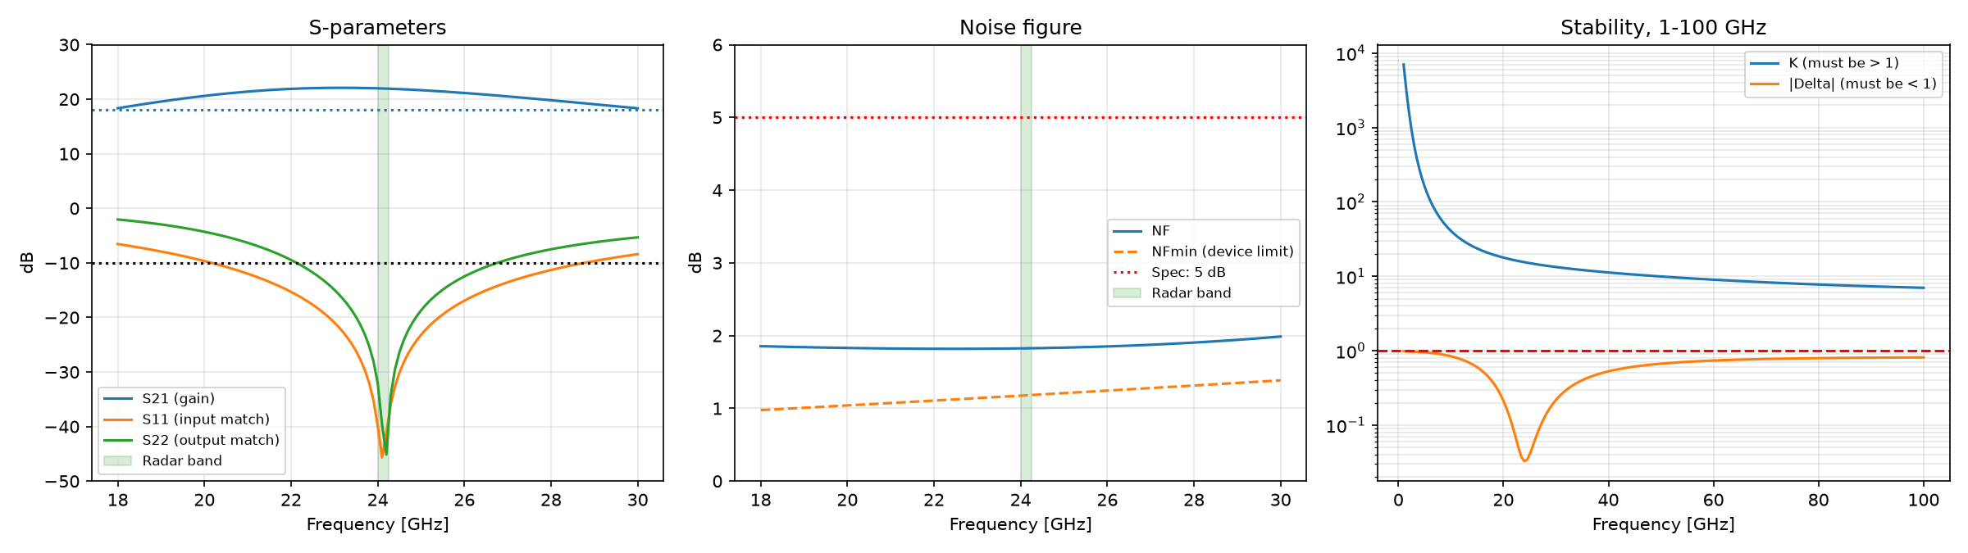
lna/stage1/lna_stage1.png
