nySe08/radar-chip-24ghz/lna/stage1/p1db.png

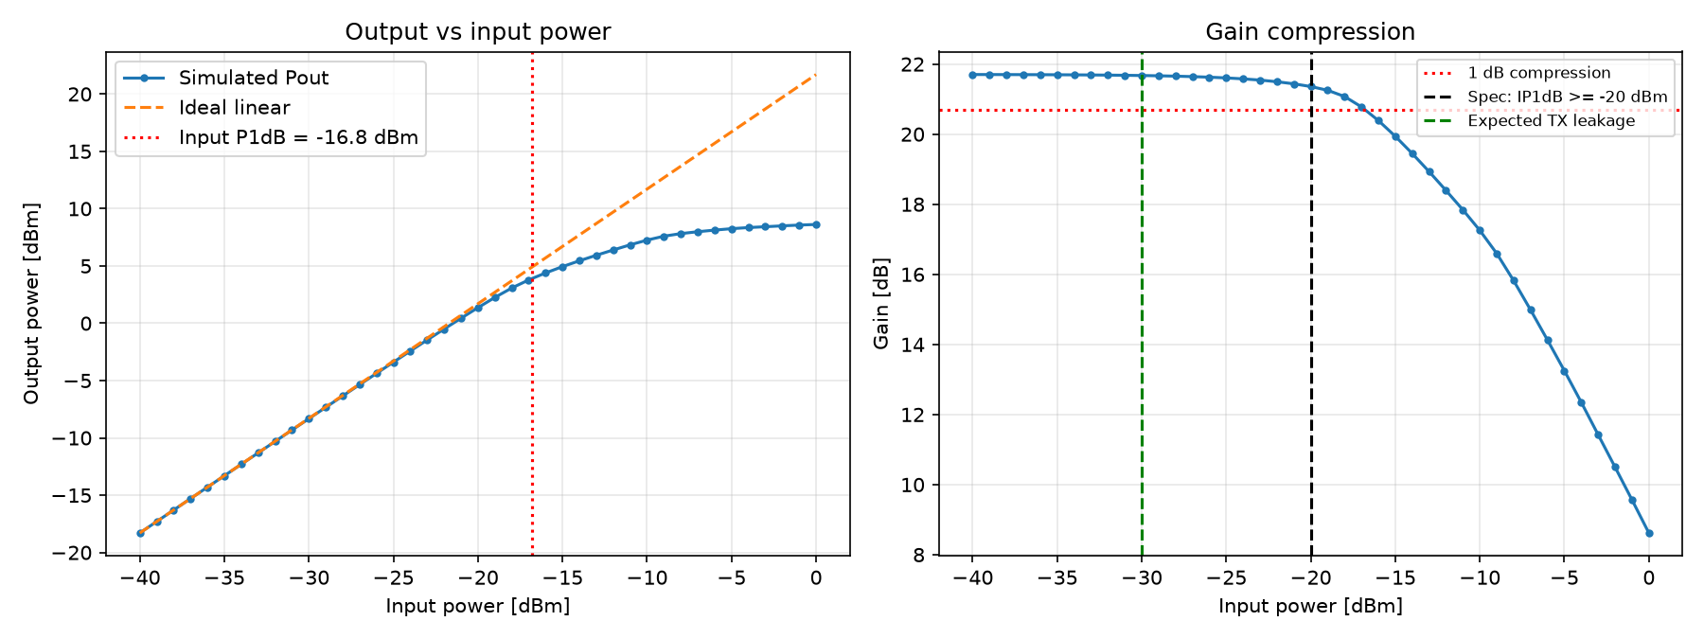
lna/stage1/p1db.png
