nySe08/radar-chip-24ghz/lo_core/layout/lo_bandselect.png

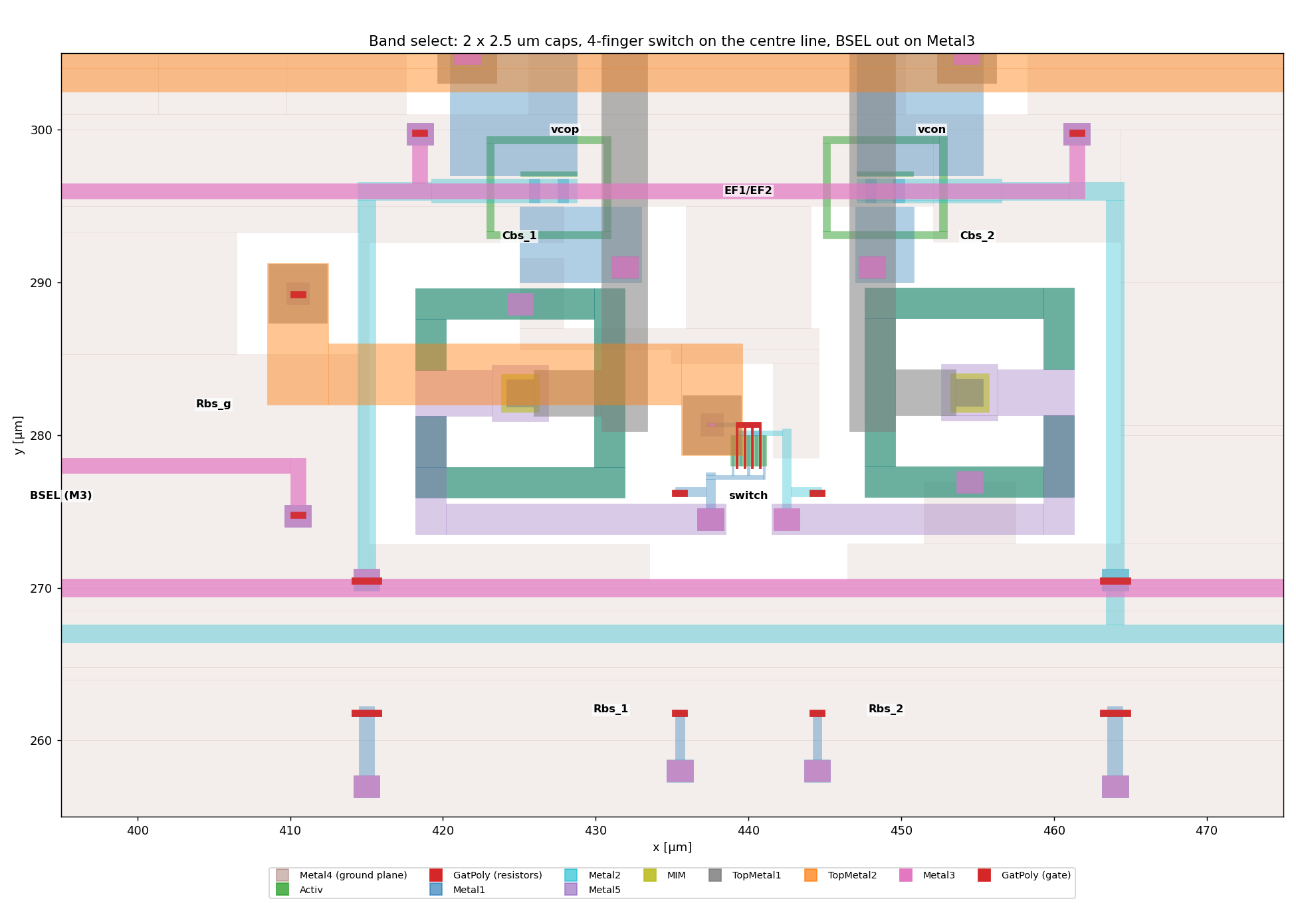
lo_core/layout/lo_bandselect.png
