nySe08/radar-chip-24ghz/lo_core/layout/lo_core_complete.png

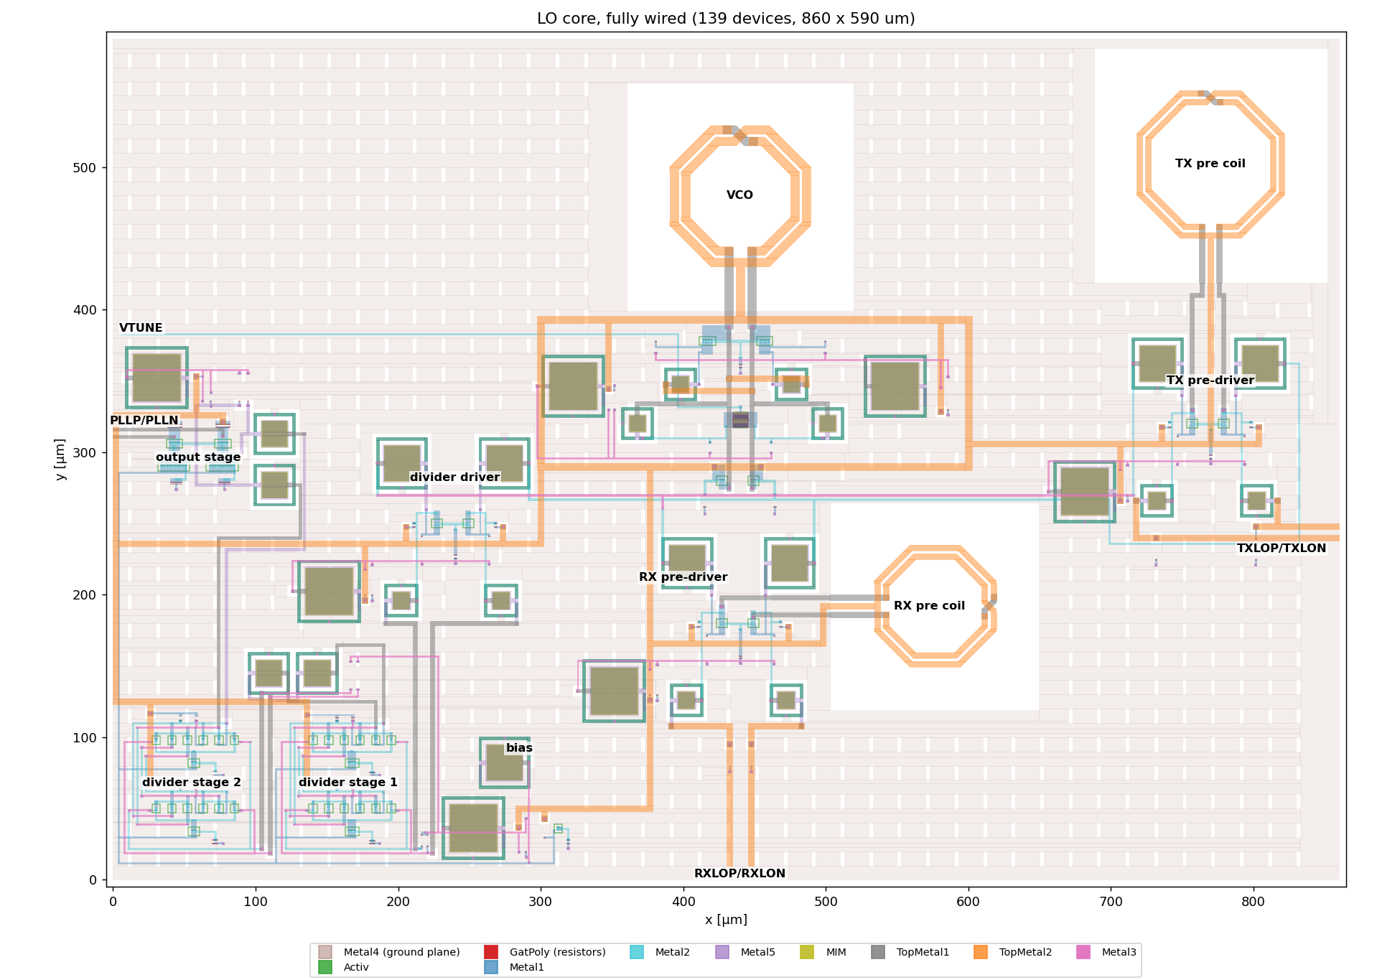
lo_core/layout/lo_core_complete.png
