nySe08/radar-chip-24ghz/lo_core/layout/lo_core_stage2.png

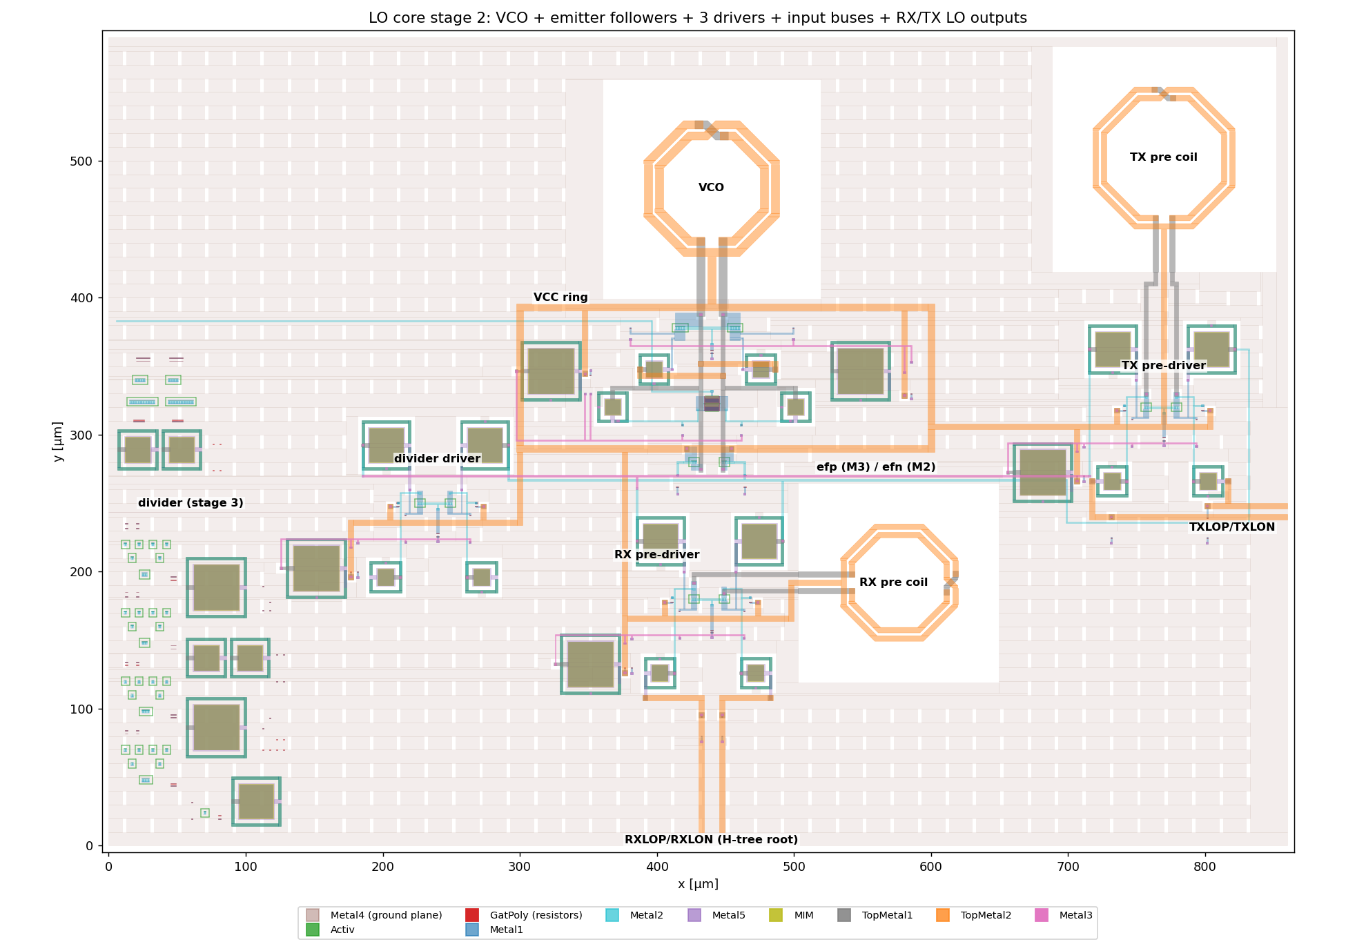
lo_core/layout/lo_core_stage2.png
