nySe08/radar-chip-24ghz/lo_core/layout/lo_div_stage3a.png

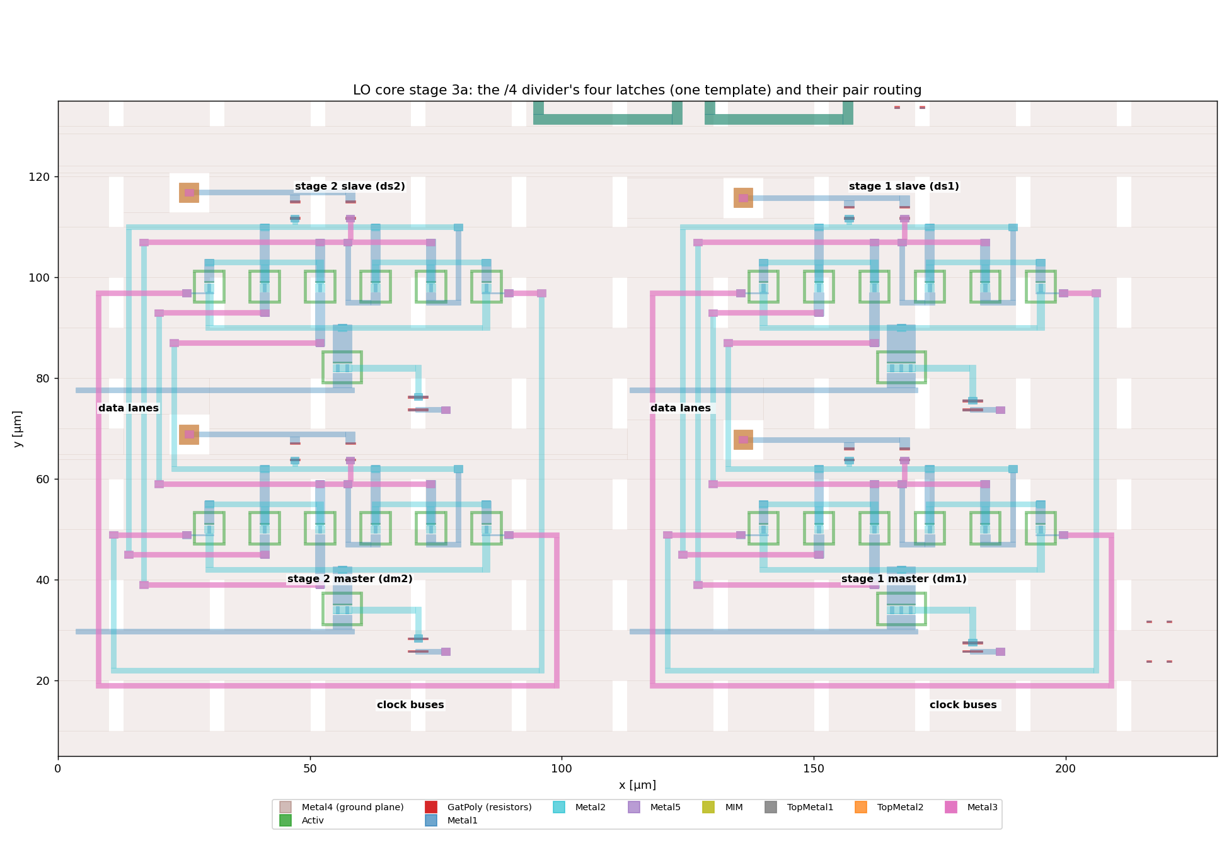
lo_core/layout/lo_div_stage3a.png
