nySe08/radar-chip-24ghz/lo_core/layout/lo_place.png

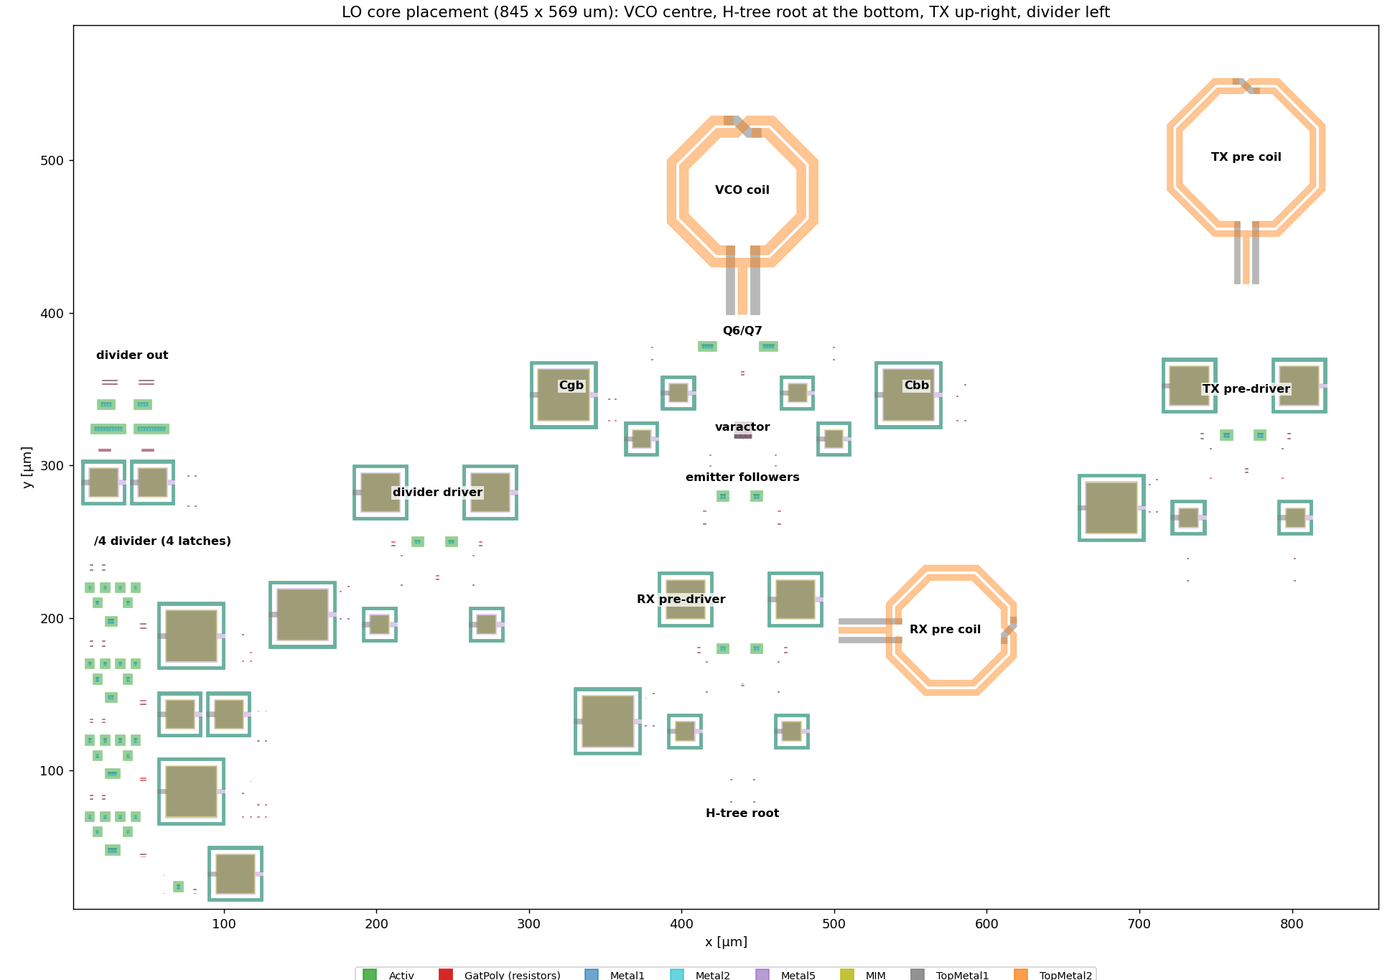
lo_core/layout/lo_place.png
