nySe08/radar-chip-24ghz/lo_core/layout/lo_vco_compact.png

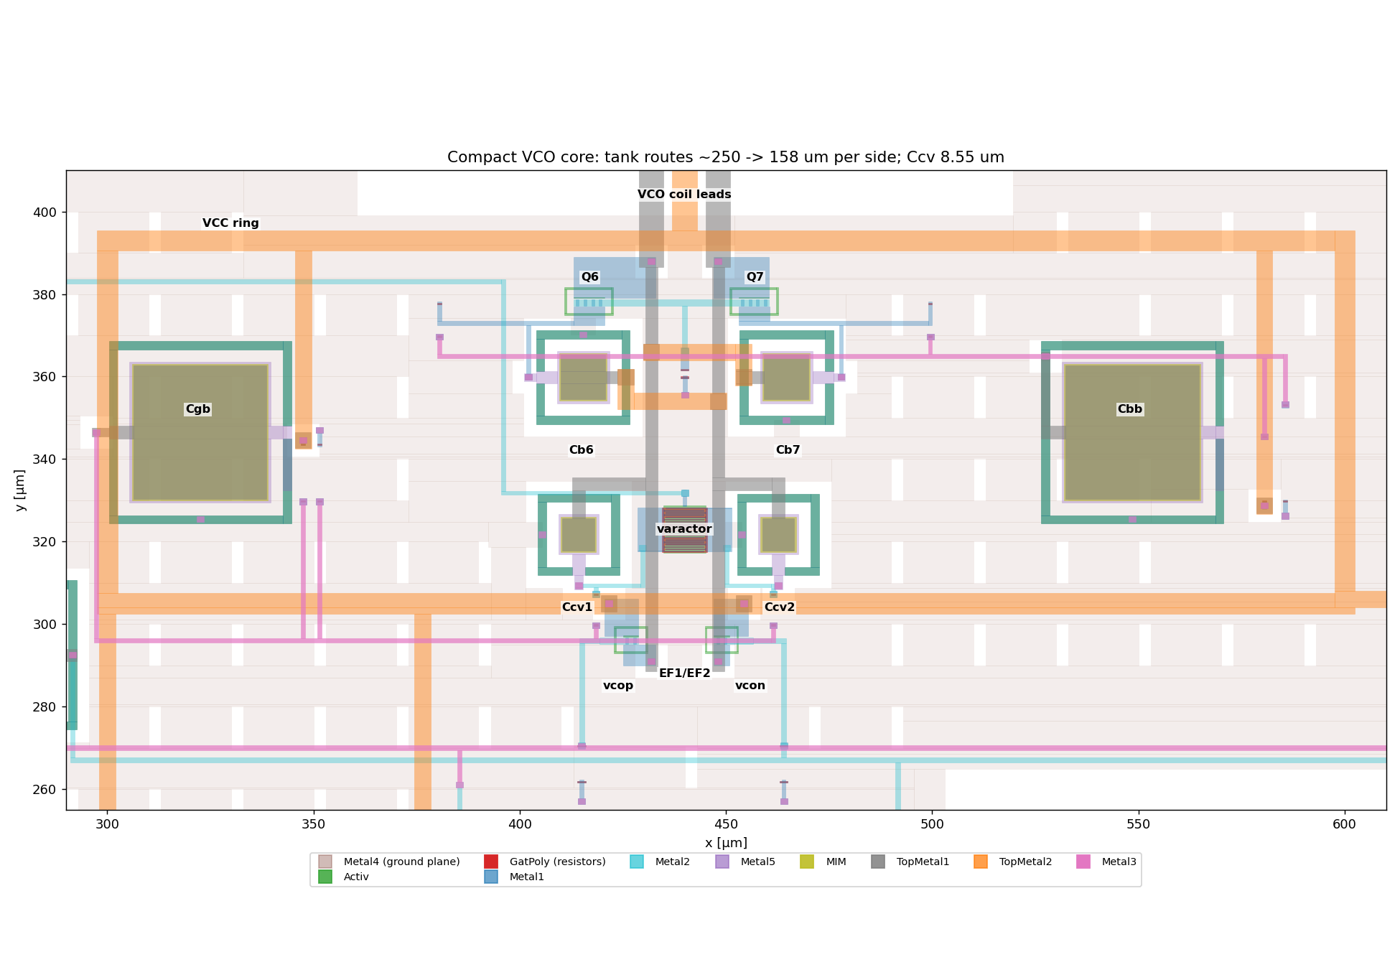
lo_core/layout/lo_vco_compact.png
