nySe08/radar-chip-24ghz/lo_core/layout/lo_vco_stage1.png

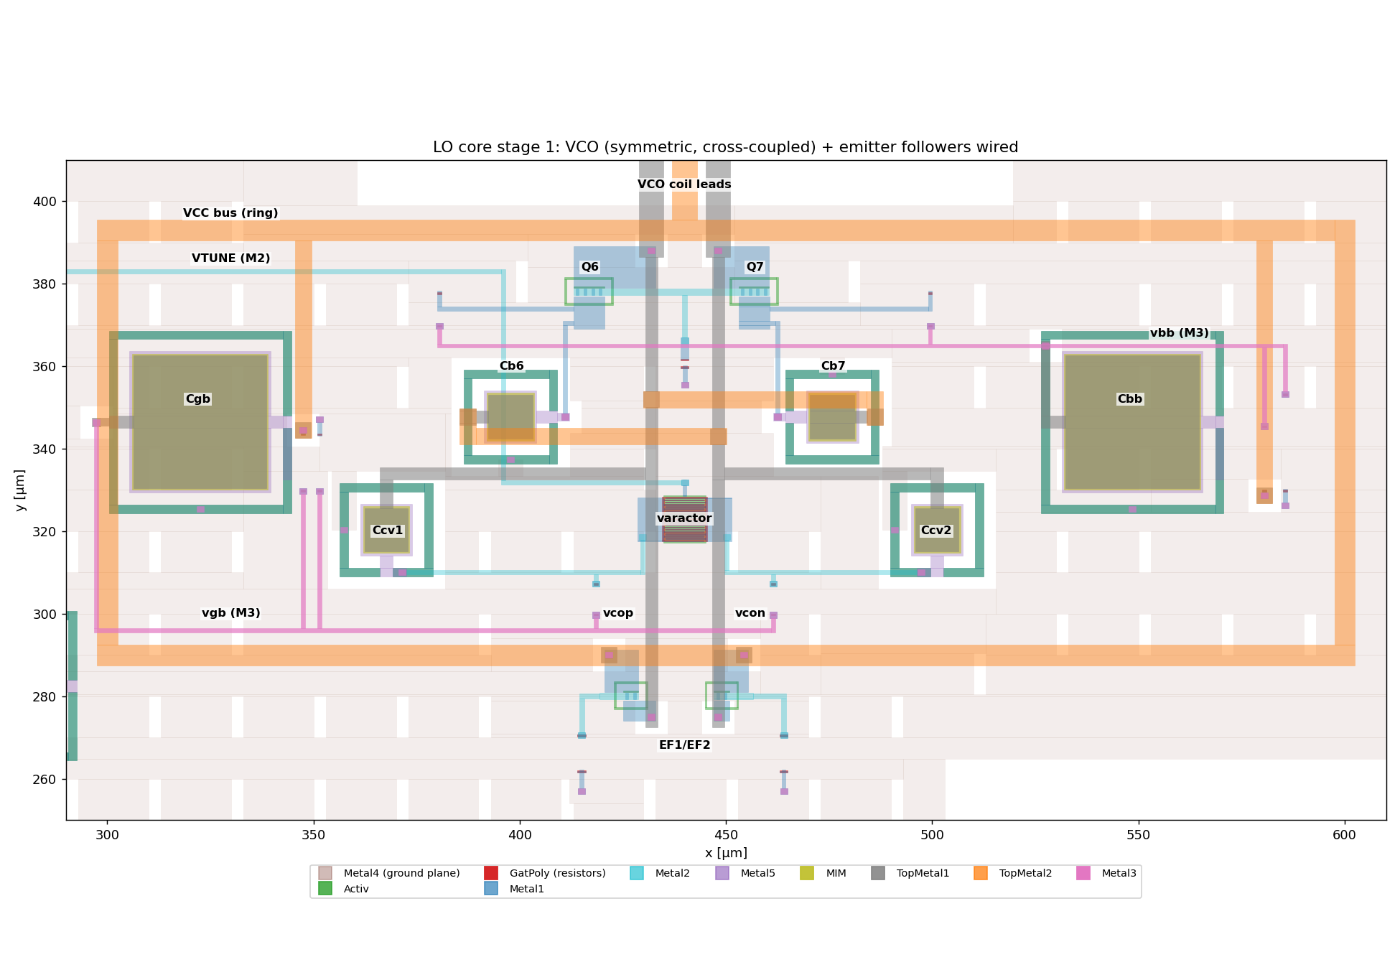
lo_core/layout/lo_vco_stage1.png
