nySe08/radar-chip-24ghz/mixer/mixer.png

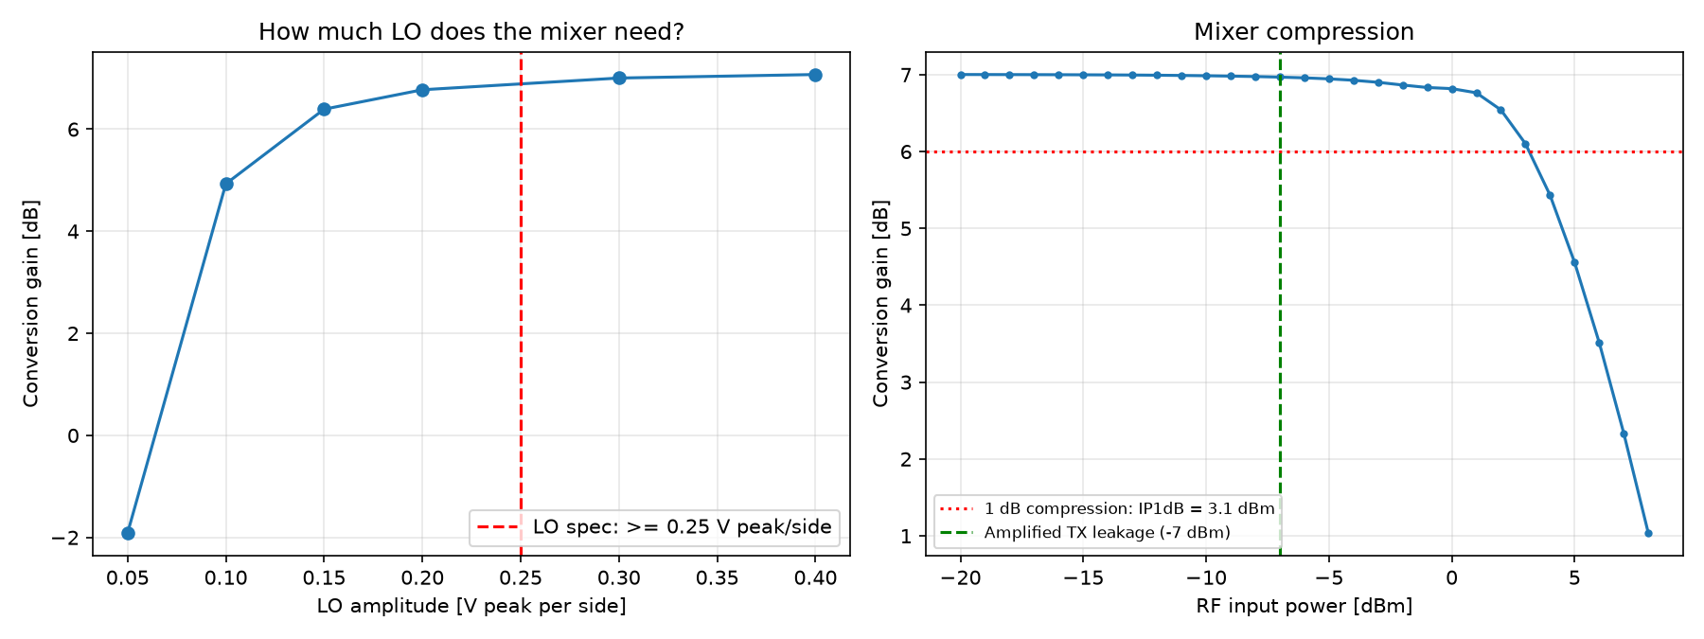
mixer/mixer.png
