nySe08/radar-chip-24ghz/model/mimo_scene.png

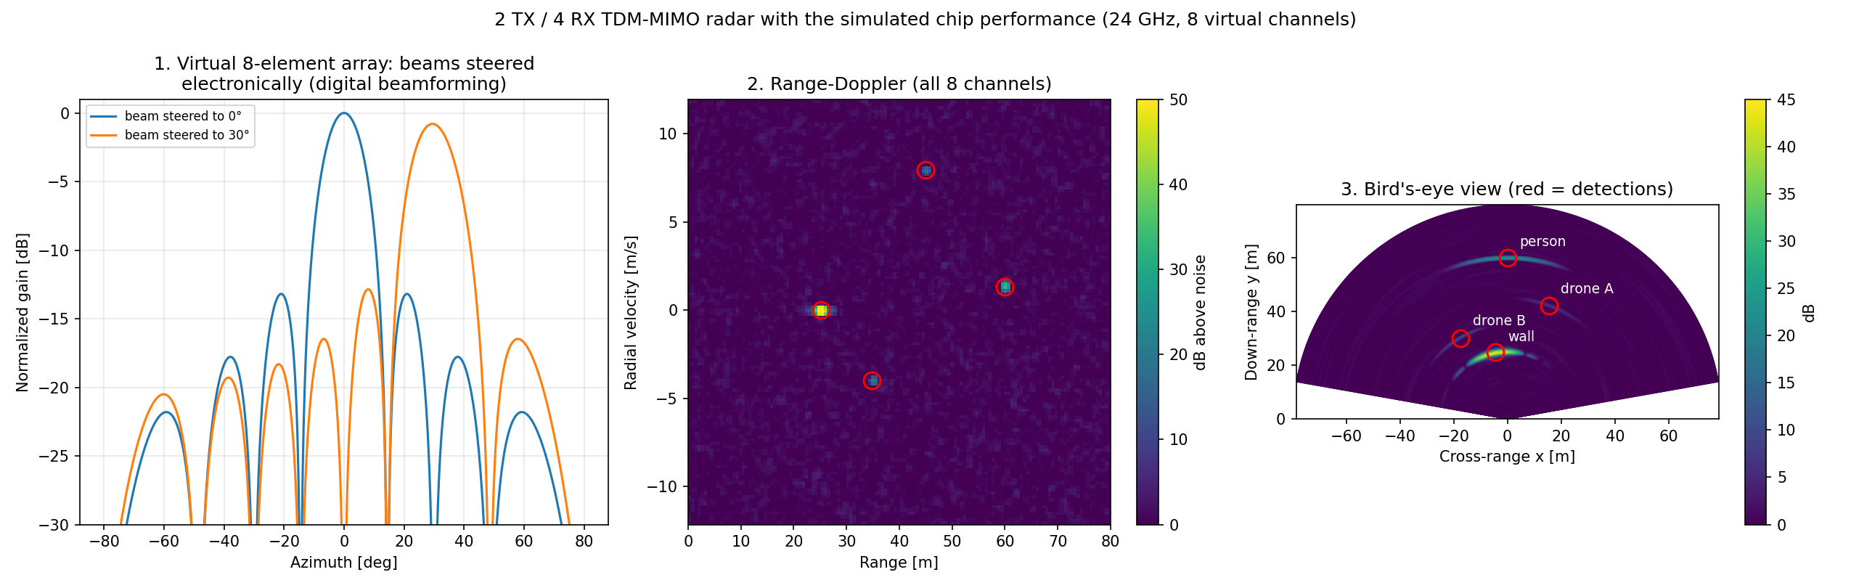
model/mimo_scene.png
