nySe08/radar-chip-24ghz/model/mimo_scene_uncal.png

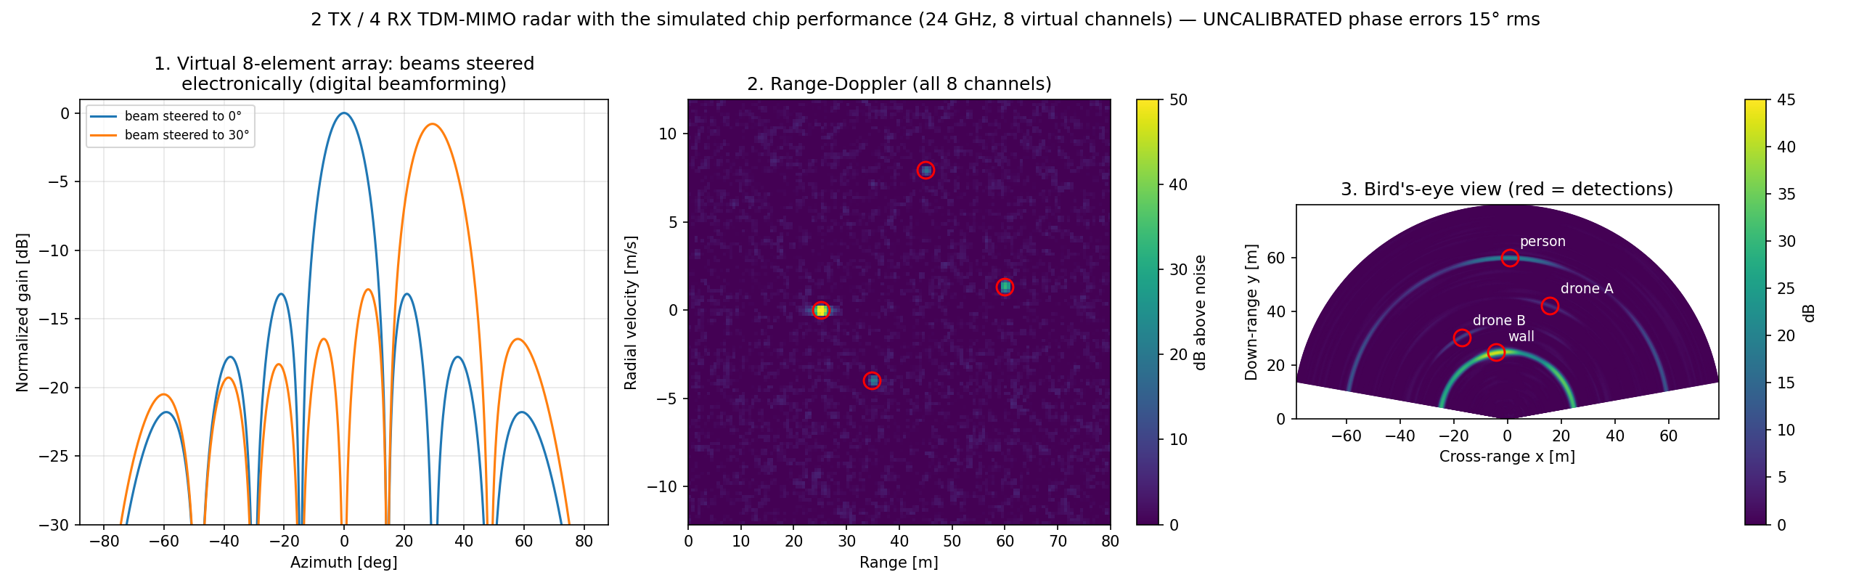
model/mimo_scene_uncal.png
