nySe08/radar-chip-24ghz/pa/pa_drive.png

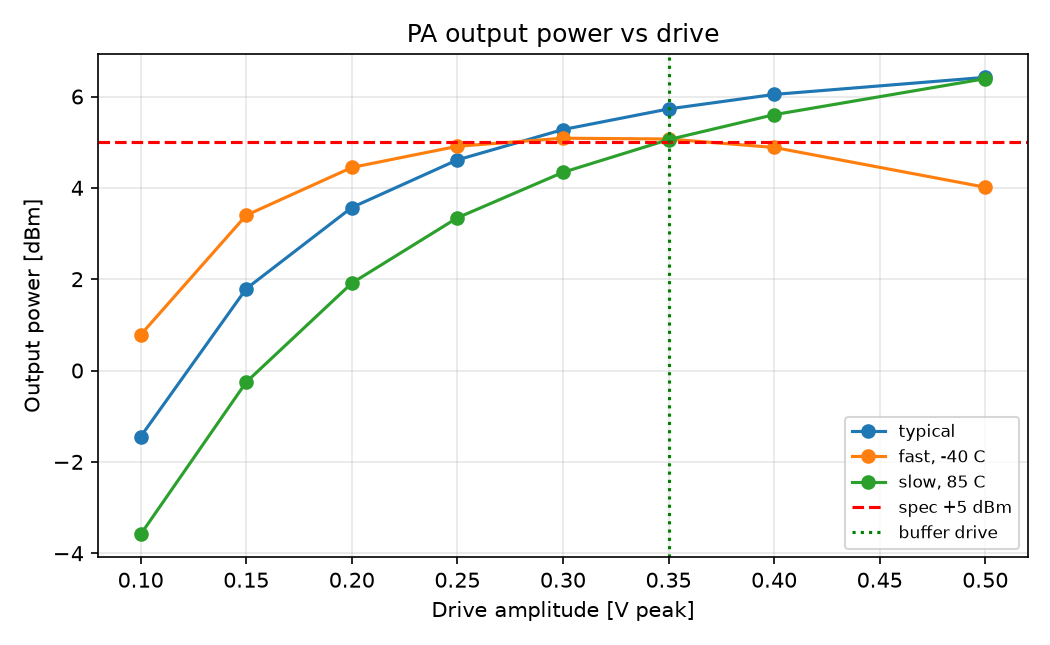
pa/pa_drive.png
