nySe08/radar-chip-24ghz/rx_tile/layout/rx_tile_v2.png

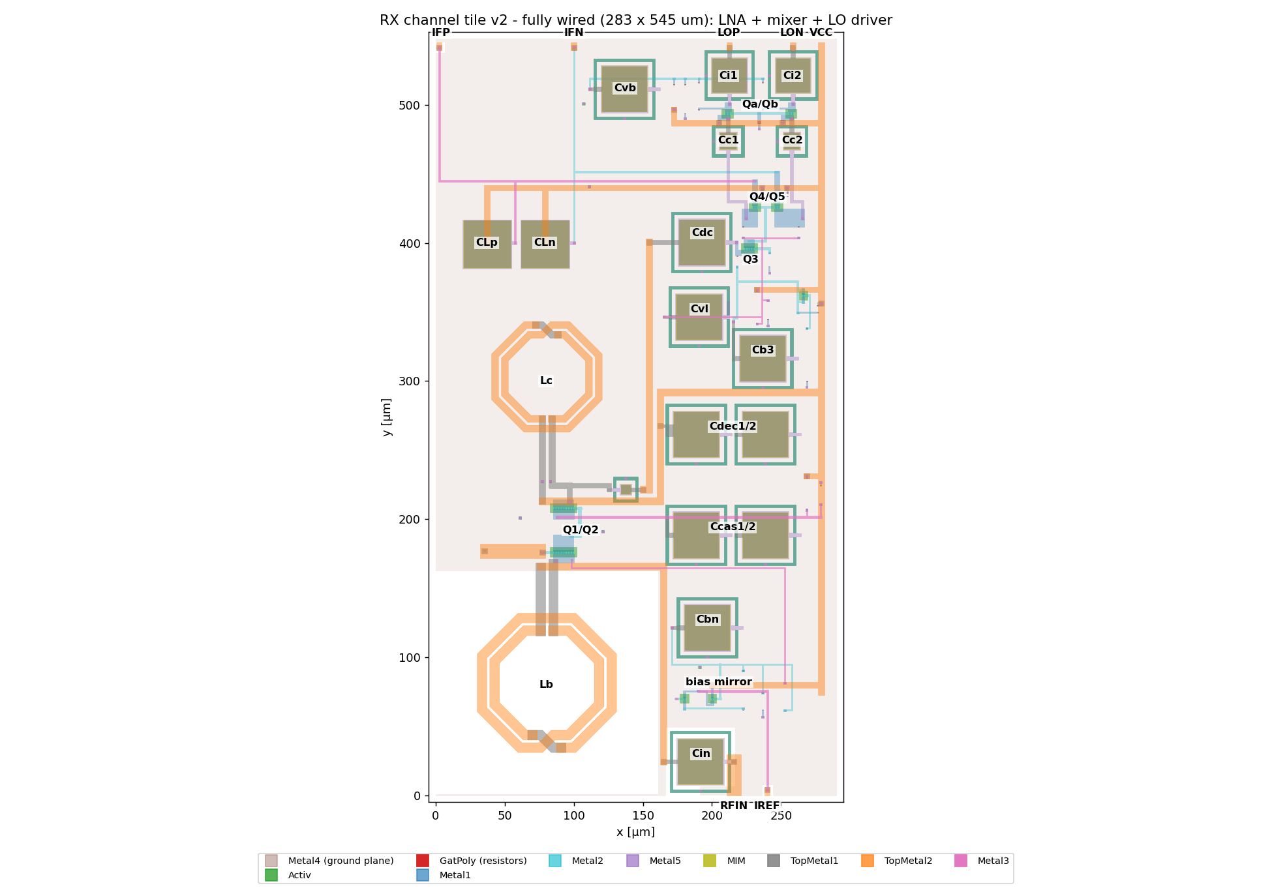
rx_tile/layout/rx_tile_v2.png
