nySe08/radar-chip-24ghz/vco/var_char.png

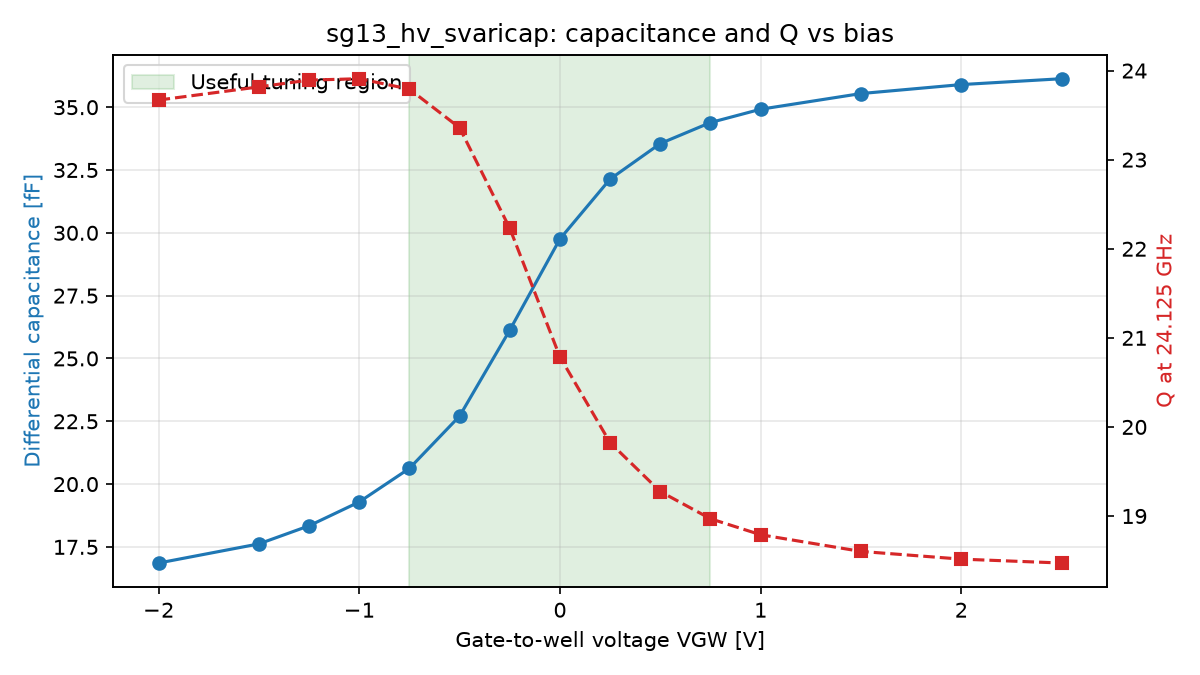
vco/var_char.png
