nySe08/radar-chip-24ghz/vco/vco.png

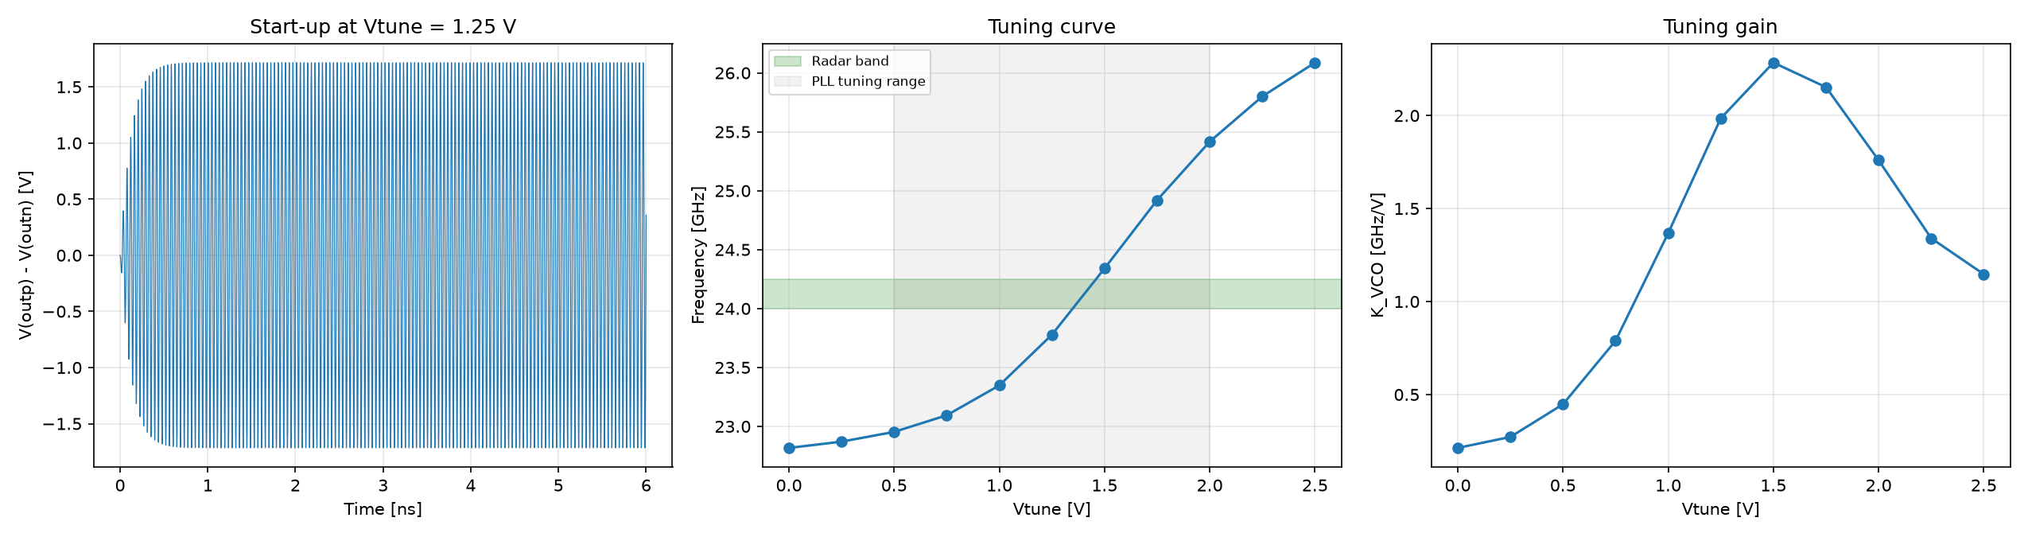
vco/vco.png
