nySe08/radar-chip-24ghz/tx/post_layout/tx_ch_k25d_pex_netlist.csv

Device | Net1 | Net2 | Capacitance [fF] | Resistance [Ω]
C1 | $29 | $32 | 1.499
C2 | $29 | GND | 2.248
C3 | $29 | VSUBS | 3.057
C4 | $31 | $32 | 0.827
C5 | $31 | $46 | 3.297
C6 | $31 | $49 | 0.188
C7 | $31 | $59 | 0.067
C8 | $31 | $67 | 3.428
C9 | $31 | $7 | 0.412
C10 | $31 | GND | 32.292
C11 | $31 | VCC | 0.766
C12 | $31 | VSUBS | 19.005
C13 | $32 | $49 | 3.19
C14 | $32 | GND | 4.588
C15 | $32 | VCC | 0.043
C16 | $32 | VSUBS | 5.309
C17 | $33 | GND | 4.057
C18 | $33 | OUT | 2.063
C19 | $33 | VSUBS | 2.249
C20 | $45 | $46 | 0.344
C21 | $45 | $49 | 0.581
C22 | $45 | $53 | 0.372
C23 | $45 | $55 | 0.434
C24 | $45 | GND | 4.072
C25 | $45 | VCC | 0.118
C26 | $45 | VSUBS | 6.001
C27 | $46 | $53 | 0.075
C28 | $46 | GND | 1.868
C29 | $46 | VCC | 1.252
C30 | $46 | VSUBS | 6.467
C31 | $49 | $55 | 0.078
C32 | $49 | GND | 1.852
C33 | $49 | VCC | 0.58
C34 | $49 | VSUBS | 6.47
C35 | $5 | $6 | 0.145
C36 | $5 | $9 | 0.157
C37 | $5 | GND | 1.935
C38 | $5 | VCC | 0.006
C39 | $5 | VSUBS | 3.026
C40 | $53 | $68 | 0.176
C41 | $53 | GND | 2.202
C42 | $53 | TXINP | 4.873
C43 | $53 | VCC | 0.008
C44 | $53 | VSUBS | 10.208
C45 | $55 | GND | 2.381
C46 | $55 | TXINN | 4.873
C47 | $55 | VSUBS | 10.174
C48 | $59 | $60 | 3.806
C49 | $59 | $67 | 1.15
C50 | $59 | $69 | 6.731
C51 | $59 | GND | 4.247
C52 | $59 | VCC | 0.025
C53 | $59 | VSUBS | 8.576
C54 | $6 | $7 | 0.165
C55 | $6 | $9 | 0.076
C56 | $6 | ENB | 0.105
C57 | $6 | GND | 5.063
C58 | $6 | VCC | 0.453
C59 | $6 | VSUBS | 7.543
C60 | $60 | $69 | 3.186
C61 | $60 | GND | 13.086
C62 | $60 | OUT | 1.685
C63 | $60 | VCC | 0.317
C64 | $60 | VSUBS | 14.092
C65 | $67 | GND | 2.573
C66 | $67 | VSUBS | 2.47
C67 | $68 | GND | 41.112
C68 | $68 | TXINP | 0.903
C69 | $68 | VCC | 0.708
C70 | $68 | VSUBS | 15.251
C71 | $69 | GND | 50.976
C72 | $69 | OUT | 1.019
C73 | $69 | VCC | 0.055
C74 | $69 | VSUBS | 14.495
C75 | $7 | $9 | 0.048
C76 | $7 | ENB | 0.8
C77 | $7 | GND | 72.114
C78 | $7 | VCC | 0.339
C79 | $7 | VSUBS | 46.647
C80 | $9 | GND | 3.25
C81 | $9 | VSUBS | 5.453
C82 | ENB | GND | 13.159
C83 | ENB | VCC | 0.041
C84 | ENB | VSUBS | 9.902
C85 | GND | OUT | 14.374
C86 | GND | TXINN | 18.428
C87 | GND | TXINP | 11.955
C88 | GND | VCC | 106.52
C89 | GND | VSUBS | 1692.789
C90 | OUT | VSUBS | 4.045
C91 | TXINN | TXINP | 1.38
C92 | TXINN | VSUBS | 7.17
C93 | TXINP | VCC | 0.096
C94 | TXINP | VSUBS | 6.929
C95 | VCC | VSUBS | 23.094
