nySe08/radar-chip-24ghz/lna/layout/pex_out/lna__lna/lna_k25d_pex_netlist.csv

Device | Net1 | Net2 | Capacitance [fF] | Resistance [Ω]
C1 | $12 | GND | 48.022
C2 | $12 | IREF | 0.159
C3 | $12 | VCC | 0.186
C4 | $12 | VSUBS | 22.593
C5 | $25 | $30 | 0.081
C6 | $25 | $39 | 1.319
C7 | $25 | GND | 80.146
C8 | $25 | VSUBS | 28.083
C9 | $29 | $35 | 0.185
C10 | $29 | GND | 11.127
C11 | $29 | RFIN | 6.598
C12 | $29 | VSUBS | 10.222
C13 | $30 | $39 | 1.246
C14 | $30 | GND | 21.467
C15 | $30 | RFOUT | 1.642
C16 | $30 | VCC | 0.628
C17 | $30 | VSUBS | 11.937
C18 | $35 | $39 | 0.117
C19 | $35 | GND | 9.545
C20 | $35 | VSUBS | 13.489
C21 | $39 | GND | 10.644
C22 | $39 | VSUBS | 8.204
C23 | $7 | GND | 2.059
C24 | $7 | IREF | 1.209
C25 | $7 | VSUBS | 7.701
C26 | GND | IREF | 12.498
C27 | GND | RFIN | 8.963
C28 | GND | RFOUT | 31.642
C29 | GND | VCC | 118.532
C30 | GND | VSUBS | 2948.854
C31 | IREF | VCC | 0.02
C32 | IREF | VSUBS | 125.433
C33 | RFIN | VSUBS | 65.455
C34 | RFOUT | VCC | 1.705
C35 | RFOUT | VSUBS | 59.721
C36 | VCC | VSUBS | 132.012
