nySe08/radar-chip-24ghz/lo_core/layout/pex_out/lo_core__lo_core/lo_core_k25d_pex_netlist.csv

Device | Net1 | Net2 | Capacitance [fF] | Resistance [Ω]
C1 | $107 | $20 | 0.867
C2 | $107 | $28 | 0.166
C3 | $107 | $29 | 0.15
C4 | $107 | $35 | 0.874
C5 | $107 | $4 | 0.008
C6 | $107 | $82 | 0.158
C7 | $107 | GND | 2.43
C8 | $107 | VCC | 0.005
C9 | $107 | VSUBS | 3.609
C10 | $109 | $20 | 1.027
C11 | $109 | $35 | 1.199
C12 | $109 | $5 | 0.008
C13 | $109 | $82 | 0.164
C14 | $109 | GND | 2.151
C15 | $109 | VSUBS | 3.534
C16 | $112 | $23 | 0.867
C17 | $112 | $31 | 0.166
C18 | $112 | $32 | 0.15
C19 | $112 | $41 | 0.874
C20 | $112 | $6 | 0.008
C21 | $112 | $83 | 0.158
C22 | $112 | GND | 2.277
C23 | $112 | VCC | 0.025
C24 | $112 | VSUBS | 3.609
C25 | $114 | $23 | 1.027
C26 | $114 | $41 | 1.199
C27 | $114 | $7 | 0.008
C28 | $114 | $83 | 0.164
C29 | $114 | GND | 2.154
C30 | $114 | VSUBS | 3.534
C31 | $144 | $155 | 0.262
C32 | $144 | $157 | 0.031
C33 | $144 | $158 | 0.323
C34 | $144 | GND | 55.089
C35 | $144 | VCC | 0.355
C36 | $144 | VSUBS | 18.037
C37 | $148 | $155 | 0.399
C38 | $148 | $157 | 0.308
C39 | $148 | $192 | 2.481
C40 | $148 | GND | 7.286
C41 | $148 | VCC | 0.044
C42 | $148 | VSUBS | 9.665
C43 | $149 | $155 | 0.853
C44 | $149 | $157 | 0.321
C45 | $149 | $158 | 0.722
C46 | $149 | $195 | 2.494
C47 | $149 | GND | 2.598
C48 | $149 | VCC | 0.085
C49 | $149 | VSUBS | 9.482
C50 | $155 | $157 | 0.295
C51 | $155 | $158 | 0.001
C52 | $155 | $195 | 0.28
C53 | $155 | GND | 15.295
C54 | $155 | RXLOP | 2.49
C55 | $155 | VCC | 0.389
C56 | $155 | VSUBS | 15.616
C57 | $157 | $158 | 0.325
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
C450 | GND | VSUBS | 5665.445
C451 | GND | VTUNE | 27.397
C452 | PLLN | PLLP | 1.298
C453 | PLLN | VCC | 0.661
C454 | PLLN | VSUBS | 6.248
C455 | PLLP | VCC | 1.303
C456 | PLLP | VSUBS | 7.159
C457 | RXLON | VSUBS | 8.739
C458 | RXLOP | VSUBS | 8.637
C459 | TXLON | TXLOP | 1.22
C460 | TXLON | VSUBS | 7.249
C461 | TXLOP | VCC | 0.09
C462 | TXLOP | VSUBS | 8.906
C463 | VCC | VSUBS | 133.354
C464 | VCC | VTUNE | 0.248
C465 | VSUBS | VTUNE | 42.581
