nySe08/radar-chip-24ghz/rx_tile/layout/pex_out/rx_tile__rx_tile/rx_tile_k25d_pex_netlist.csv

Device | Net1 | Net2 | Capacitance [fF] | Resistance [Ω]
C1 | $12 | $19 | 0.27
C2 | $12 | $6 | 0.199
C3 | $12 | $8 | 0.028
C4 | $12 | GND | 43.422
C5 | $12 | IREF | 0.917
C6 | $12 | VCC | 0.358
C7 | $12 | VSUBS | 23.389
C8 | $19 | $26 | 0.094
C9 | $19 | $30 | 0.017
C10 | $19 | $6 | 1.488
C11 | $19 | GND | 36.364
C12 | $19 | VCC | 0.02
C13 | $19 | VSUBS | 23.423
C14 | $26 | $30 | 1.896
C15 | $26 | $34 | 1.165
C16 | $26 | GND | 8.319
C17 | $26 | VCC | 0.062
C18 | $26 | VSUBS | 12.467
C19 | $30 | $34 | 0.101
C20 | $30 | GND | 104.876
C21 | $30 | VCC | 0.202
C22 | $30 | VSUBS | 28.759
C23 | $34 | $38 | 1.54
C24 | $34 | GND | 10.264
C25 | $34 | VCC | 1.847
C26 | $34 | VSUBS | 9.822
C27 | $38 | $47 | 0.028
C28 | $38 | $49 | 0.005
C29 | $38 | $61 | 0.595
C30 | $38 | $64 | 0.063
C31 | $38 | GND | 23.643
C32 | $38 | VCC | 2.362
C33 | $38 | VSUBS | 13.827
C34 | $47 | $49 | 1.043
C35 | $47 | $61 | 0.353
C36 | $47 | $64 | 1.038
C37 | $47 | $67 | 0.015
C38 | $47 | $68 | 0.021
C39 | $47 | GND | 54.306
C40 | $47 | VCC | 0.18
C41 | $47 | VSUBS | 18.98
C42 | $49 | $53 | 0.607
C43 | $49 | GND | 42.953
C44 | $49 | VCC | 0.551
C45 | $49 | VSUBS | 18.864
C46 | $53 | GND | 2.025
C47 | $53 | VCC | 0.082
C48 | $53 | VSUBS | 3.265
C49 | $6 | GND | 19.15
C50 | $6 | RFIN | 7.088
C51 | $6 | VSUBS | 18.085
C52 | $61 | $64 | 0.629
C53 | $61 | GND | 1.586
C54 | $61 | VSUBS | 2.628
C55 | $64 | $67 | 0.348
C56 | $64 | $68 | 0.327
C57 | $64 | GND | 4.031
C58 | $64 | IFN | 0.289
C59 | $64 | IFP | 0.292
C60 | $64 | VSUBS | 7.281
C61 | $67 | $86 | 2.44
C62 | $67 | GND | 12.28
C63 | $67 | IFN | 0.098
C64 | $67 | IFP | 0.077
C65 | $67 | VCC | 0.468
C66 | $67 | VSUBS | 11.532
C67 | $68 | $82 | 2.44
C68 | $68 | GND | 14.711
C69 | $68 | IFN | 0.017
C70 | $68 | VCC | 0.674
C71 | $68 | VSUBS | 17.182
C72 | $78 | $84 | 0.372
C73 | $78 | $86 | 0.086
C74 | $78 | $89 | 0.057
C75 | $78 | GND | 14.082
C76 | $78 | LOP | 4.879
C77 | $78 | VCC | 0.01
C78 | $78 | VSUBS | 6.596
C79 | $8 | GND | 2.198
C80 | $8 | IREF | 0.076
C81 | $8 | VSUBS | 5.484
C82 | $80 | $82 | 0.086
C83 | $80 | $84 | 0.434
C84 | $80 | GND | 13.493
C85 | $80 | LON | 4.879
C86 | $80 | VCC | 0.199
C87 | $80 | VSUBS | 6.658
C88 | $82 | $84 | 0.615
C89 | $82 | GND | 1.444
C90 | $82 | VCC | 1.126
C91 | $82 | VSUBS | 5.034
C92 | $84 | $86 | 0.332
C93 | $84 | GND | 3.609
C94 | $84 | VCC | 0.236
C95 | $84 | VSUBS | 5.933
C96 | $86 | GND | 1.469
C97 | $86 | VCC | 1.126
C98 | $86 | VSUBS | 5.033
C99 | $89 | GND | 42.052
C100 | $89 | LOP | 0.447
C101 | $89 | VSUBS | 17.487
C102 | GND | IFN | 30.953
C103 | GND | IFP | 71.654
C104 | GND | IREF | 18.892
C105 | GND | LON | 16.624
C106 | GND | LOP | 16.979
C107 | GND | RFIN | 4.499
C108 | GND | VCC | 223.259
C109 | GND | VSUBS | 1766.105
C110 | IFN | IFP | 0.723
C111 | IFN | VCC | 7.667
C112 | IFN | VSUBS | 35.592
C113 | IFP | VCC | 8.254
C114 | IFP | VSUBS | 38.403
C115 | IREF | VCC | 0.422
C116 | IREF | VSUBS | 15.102
C117 | LON | VCC | 0.224
C118 | LON | VSUBS | 2.623
C119 | LOP | VSUBS | 2.517
C120 | RFIN | VSUBS | 8.869
C121 | VCC | VSUBS | 60.076
