nySe08/radar-chip-24ghz/floorplan/floorplan_test_chip.png

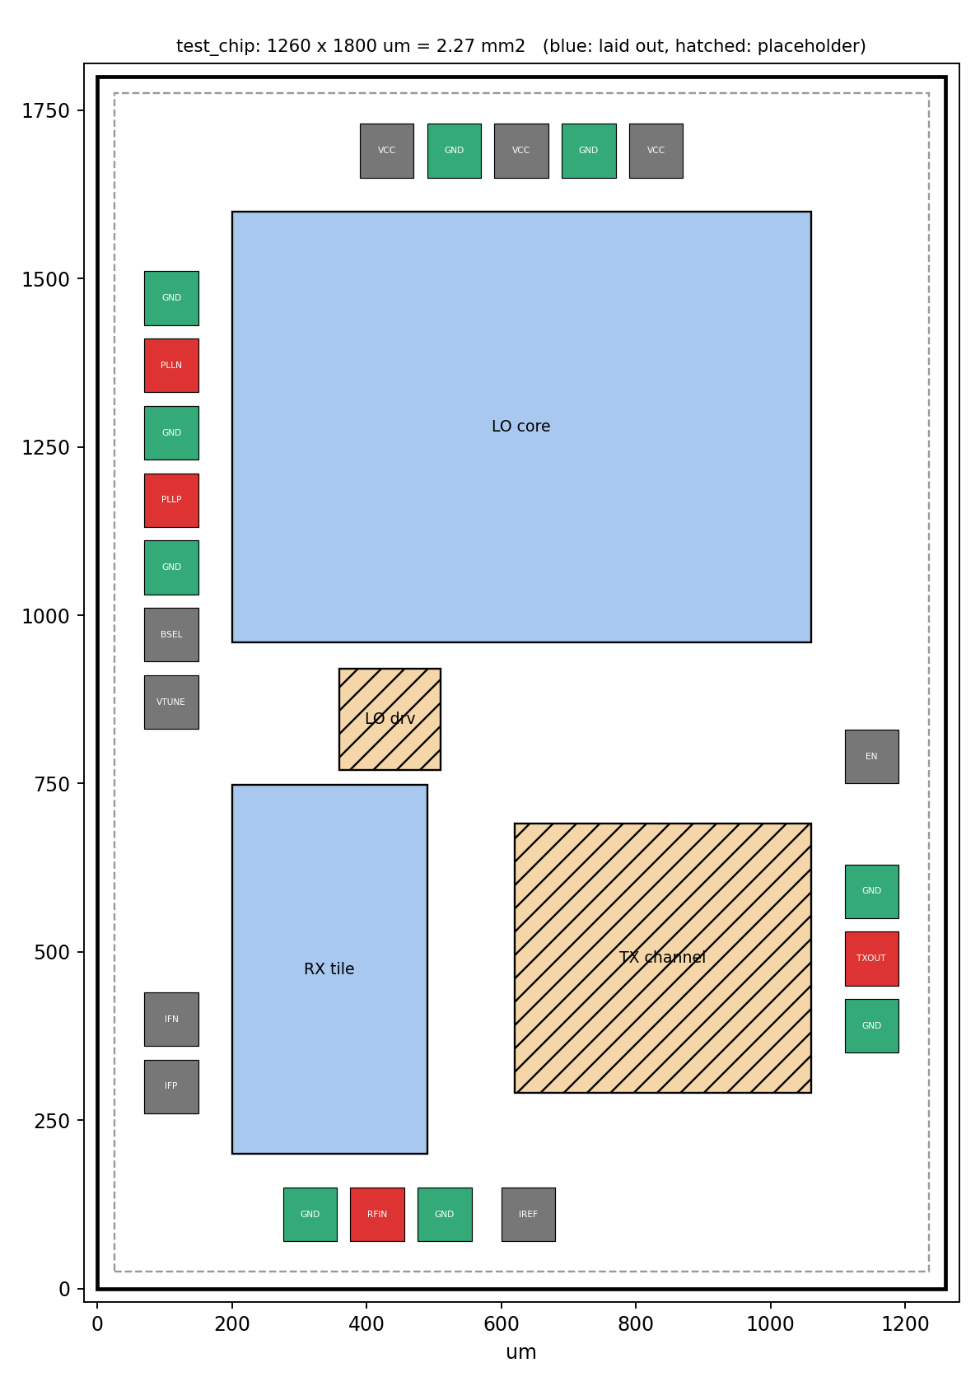
floorplan/floorplan_test_chip.png
