nySe08/radar-chip-24ghz/(commit log)

2026-10-07 System model, HBT characterization, LNA stage 1 with ideal passives
2026-10-07 LNA: current-mirror bias network, verified over corners and temperature
2026-10-08 Mixer: Single-balanced, CG 7 dB, IP1dB +3.1 dBm, LO spec 0.25 V/side
2026-10-08 Docs: LNA and mixer schematics
2026-10-08 VCO: varactor characterization, cross-coupled LC VCO 22.95-25.42 GHz, all corners pass
2026-10-10 Phase array: LO tree (MC 10.3 deg rms), PA enable (71-79 dB isolation), EM calibrated LNA
2026-10-18 TX channel: layout generator, LVS netlists, sign off passed (DRC, antenna, LVS, extraction gate)
